joey12725/bubblelink/hardware/pcb/BubbleLink_CTRL_v1_2_PCBWay/verification/manufacturing_qa/REQUIREMENTS_TRACEABILITY.md

# Manufacturing QA requirements traceability

| ID | Frozen requirement | Source / rationale | Automated evidence | Release criterion | Manual complement |
|---|---|---|---|---|---|
| MQA-001 | Exact component population, values, MPNs, mount technology, and DNP state | `frozen_design.json`; design source; DFM BOM | `CMP-001`–`CMP-004` | Exact match | Confirm received reels/labels and no unapproved substitution |
| MQA-002 | Standard and polarity-critical pin mapping is preserved from logical pin through physical pad | Device datasheet pinouts frozen in `critical_pin_labels` | `PIN-001`, `PIN-002`, `KIC-005` | No missing, extra, or renumbered pad | Inspect PCBWay placement preview/photo for pin 1 and D1 cathode |
| MQA-003 | Controller and pump topology is exact | Frozen 23 connectivity groups, explicit N−1 trees, and PRIME internal pole pairs | `NET-001`, `NET-002`, `NET-003`, `KIC-006` | Every expected endpoint shares only its frozen net; 111 two-terminal edges form cycle-free trees; switch pairs are 1-2 and 3-4 | Probe assembled-board shorts/continuity before power |
| MQA-004 | Board is 50 × 40 mm, two-layer, 1.6 mm FR-4 | System docs and PCBWay order handoff | `BRD-001`, `GBR-003`, `KIC-002` | Three serialized representations agree | Confirm quote selection remains 1.6 mm / 2 layer / 1 oz |
| MQA-005 | Four 3.2 mm NPTH holes use the 43 × 33 mm pattern | Mechanical requirements | `BRD-002`, `GBR-005`, `KIC-007` | Exact count, diameter, and relative coordinates | 1:1 print and hardware dry-fit |
| MQA-006 | Mounting holes have 1.0 mm copper-edge clearance on both layers | Electrical/mechanical robustness requirement | `BRD-003`, `BRD-004` | Both-layer keepouts and geometric copper clearance pass | Inspect CAM render on both copper layers |
| MQA-007 | No unresolved serialized PCB or DRC/unconnected error | Fabrication release baseline | `CIR-003`, `CIR-004`, `DRC-001` | All counts zero | PCBWay CAM feedback resolved before approval |
| MQA-008 | General copper width ≥0.20 mm; pump paths are actually ≥1.0/1.2 mm and do not neck through single series vias; J1+→TP1 is a classified 0.75 mm non-load measurement spur | Current capacity, mounting keepout, and fabrication floor | `TRC-001`–`TRC-005`, `GBR-004`, `KIC-003` | Every representation meets its applicable floor; load-current edges are via-free except the exact reviewed three-via GND bank; the 0.75 mm exception terminates only at TP1 | Review high-current path geometry and thermal behavior |
| MQA-016 | J1 GND→Q2 source uses exactly three 0.30/0.60 mm vias at 0.85 mm pitch, at least 0.25 mm pad-edge spacing, and one continuous bottom GND pour | Release-critical current-return review | `TRC-005` | Exact via/transition coordinates and GND connectivity key match; all three via pads overlap top copper; all bank centers and ten bottom-route points lie in one bottom GND BREP | Inspect the bank and bottom pour in KiCad/CAM; confirm no thermal relief necking |
| MQA-017 | All 40 serialized component courtyards are present once and pairwise disjoint; reviewed R18/C12 gap is at least 0.06 mm | Independent aggregate placement audit after a 0.13 mm R18/C12 overlap was found | `CIR-002`, `PLC-001`, DRC aggregate-placement category | No courtyard overlap/touch; exact ownership/count; reviewed local clearance preserved | Inspect dense upper-left placement and access in KiCad/assembly render |
| MQA-009 | Exactly 56 vias use drill ≥0.30 mm and diameter ≥0.60 mm, with cross-export-consistent count; the PTH drill file has 42 component holes + 56 vias = 98 hits | PCBWay-capable robust geometry | `CIR-002`, `VIA-001`, `GBR-006`, `KIC-003`, `KIC-008` | No undersize via; exact counts agree across circuit, KiCad, and Excellon | Inspect tenting/plating selection in quote/CAM |
| MQA-010 | Exact nine-file, top-assembly two-layer Gerber/Excellon set is parseable; bottom paste/legend are absent | PCBWay fabrication upload requirement | `GBR-001`, `GBR-002`, `GBR-003`, `GBR-005`, `GBR-006` | Exact required roles/count, syntax, dimensions, and drills pass; forbidden bottom assembly roles absent | PCBWay CAM preview sign-off |
| MQA-018 | F.Paste is flash-only and contains exactly the 92 populated top-SMT rectangles at full 1.00× copper-pad dimensions; no R22 DNP, PTH, fiducial, or bottom aperture | Prevent under-printed joints, DNP loading, paste on through-hole pads/fiducials, and accidental bottom assembly | `GBR-007` | One-to-one center and rectangle-dimension match to copper pads owned by the 41 populated SMT refs | Inspect isolated F.Paste CAM preview before assembly approval |
| MQA-011 | KiCad source is a routed, matching, inspectable manufacturing representation | Editable-source and cross-export requirement | `KIC-001`–`KIC-007` | Stack, traces, footprints, pads, nets, and holes pass | Open in KiCad and inspect zones, courtyard, mask, legend |
| MQA-012 | PCBWay BOM contains exactly the 41 top-SMT refs with reconciled quantities and exact MPNs | Assembly scope | `BOM-001`, `BOM-002` | No missing/extra/DNP/THT ref; all MPN/value checks pass | Approve substitutions only through engineering review |
| MQA-013 | CPL contains exactly one valid top placement for each BOM ref | Assembly scope | `CPL-001`, `CPL-002` | BOM=CPL=41 refs; positions/rotations reconcile | Verify PCBWay placement preview and polarity drawing |
| MQA-014 | Every ordered artifact is frozen by SHA-256 | Prevent mixed/stale exports | `HASH-001`, `HASH-002` | All bytes match and all inputs are covered | Record the passing report alongside the quote/order |
| MQA-015 | Automated manufacturing pass does not waive external hardware gates | Limits of CAD/model evidence | Explicit `PENDING`/README separation | Release command exits 0 **and** system-doc bench gates signed | ACS window, pump/PTC, startup, EMI, fit, moisture/vibration tests |
