joey12725/bubblelink/hardware/pcb/BubbleLink_CTRL_v1_2_PCBWay/verification/analog_model/requirements_traceability.csv

requirement_id | source | source_section | requirement | frozen_implementation | automated_test_ids | manual_test_ids | verification_status | release_gate
BL-PWR-001 | 02_PCB_Design_Input_Specification.md | 6.1 Power-up | Pump remains off at power-up. | TLV1822 open-drain POR is Hi-Z; TLV803 clamps HOLD through R23; Q3 is off and R15 holds Q2 gate low. | SAFE-001;PWR-000;PWR-001;PWR-002;MC | PWR-004 | MODEL_PASS_BENCH_REQUIRED | Zero pump motion during hard plug and 0.1/1/10/100 V/s ramps
BL-PWR-002 | 02_PCB_Design_Input_Specification.md | 5 Electrical interfaces | J1 accepts 4.75-5.25 V. | References are ratiometric; U2 A43 is below the minimum normal rail. | DET-001;DET-002;TMR-001;PWR-001;MC | B-001;PWR-004 | MODEL_PASS_BENCH_REQUIRED | All rails and functions pass at 4.75/5.00/5.25 V
BL-IDLE-001 | 02_PCB_Design_Input_Specification.md | 6.2 Idle | DET_N high; HOLD low; pump off. | Detector pull-up plus R21 HOLD decay; U1B released; Q3 off; R15 gate pulldown. | SAFE-001;TMR-004;PWR-000 | B-002 | MODEL_PASS_BENCH_REQUIRED | Q2 gate remains below 0.02 V at idle over temperature
BL-DET-001 | 02_PCB_Design_Input_Specification.md | 6.3 Gun starts | ACS_OUT rise asserts detection and starts pump. | R1/C5 filter; U1A; Q1 DMP2065UQ-7 charges HOLD through R20; U1B/Q3 command Q2. | DET-001;DET-003;DET-005;START-001;START-002;MC | B-003;B-006 | MODEL_PASS_BENCH_REQUIRED | Minimum qualified real gun profile detects at 0/25/50 C
BL-DET-002 | 02_PCB_Design_Input_Specification.md | 2 Functions included | Reject motor noise and current chatter. | R1/C5 low-pass plus R5 detector hysteresis; R19 limits wiper loading. | DET-001;DET-004;DET-005;MC | B-003;EMI-001 | MODEL_PASS_BENCH_REQUIRED | No false or multiple DET_N transitions during PWM and EMI tests
BL-DET-003 | 02_PCB_Design_Input_Specification.md | 7 Adjustable ranges | VTH adjustable approximately 2.20-2.80 V. | R2/RV1/R3 divider with R19 and R5 included in exact nodal model. | DET-002;MC | B-003 | MODEL_PASS_BENCH_REQUIRED | Measured RV1 endpoints include actual idle/active sensor window
BL-DET-004 | 03_Controller_Circuit_Requirements.md | 3 Comparator A output and hysteresis | R5=4.7 MOhm and hysteresis only a few millivolts. | R5 is 4.7 MOhm from DET_N to VTH. | DET-001;MC | B-003 | MODEL_PASS_BENCH_REQUIRED | Measured turn-on/release separation 3-7 mV without chatter
BL-STOP-001 | 02_PCB_Design_Input_Specification.md | 6.4 Gun stops | Pump continues for adjustable delay then turns off. | HOLD discharges through (R9+RV2)||R21 to the U1B falling threshold. | TMR-002;TMR-003;TMR-004;MC | B-004 | MODEL_PASS_BENCH_REQUIRED | Every trigger release shuts pump off; 350 ms target reachable
BL-TMR-001 | Frozen circuit.tsx | Timer comparator | U1B +=VDELAY and -=HOLD with active-low TIMER_N. | TLV1822 channel B sinks TIMER_N only while HOLD exceeds VDELAY; Q3 then sources Q2 gate. | SAFE-001;START-001;TMR-001 | PWR-004 | MODEL_PASS_BENCH_REQUIRED | Correct active-low TIMER_N truth table on hardware
BL-TMR-002 | Frozen circuit.tsx | True hysteresis | R13=4.7 MOhm TIMER_N-to-VDELAY. | R13 shifts VDELAY high while off and low while on. | TMR-001;MC | EMI-001 | MODEL_PASS_BENCH_REQUIRED | One clean timer transition during 10000 inductive cycles
BL-TMR-003 | Frozen circuit.tsx | Timer values | R9=10 kOhm; RV2=100 kOhm; R21=1 MOhm; C7=CGA5L1X7R1E685K160AC 6.8 uF. | R21 is permanent fail-safe discharge; exact C7 production part has 6.8 uF +/-10% X7R rating. | TMR-002;TMR-003;TMR-004;MC | B-004 | MODEL_PASS_BENCH_REQUIRED | Measure assembled C7 and all delay endpoints over 0-50 C
BL-TMR-004 | 02_PCB_Design_Input_Specification.md | 7 Adjustable ranges | Clockwise RV2 increases delay. | RV2 wiper is strapped to the high end; resistance from HOLD to ground increases 0-100 kOhm. | TMR-003 | B-004 | MODEL_PASS_BENCH_REQUIRED | Physical trimmer rotation verified clockwise-longer
BL-CHG-001 | Frozen circuit.tsx | HOLD fast charge | C6=22 uF C3225X7R1E226M250AB; R20=2.2 kOhm limits charge current. | Exact two-node C6/VMID-to-C7/HOLD transient model includes R20 and Q1. | START-001;START-002;MC | B-005 | MODEL_PASS_BENCH_REQUIRED | Assembled C6/C7 effective values and trigger latency measured at corners
BL-PRIME-001 | 02_PCB_Design_Input_Specification.md | 6.5 PRIME | Momentary PRIME grounds DET_N and uses normal delay path. | SW1/J4 drive DET_N; Q1/R20/U1B/Q3 use the normal command path. | START-001;TMR-002 | B-006 | MODEL_PASS_BENCH_REQUIRED | 1000 press/release cycles; release invokes configured delay
BL-Q1-001 | Frozen circuit.tsx | Q1 | Q1 is DMP2065UQ-7 and must charge HOLD at low DET_N drive. | DMP2065UQ threshold maximum 0.9 V; modeled current remains below its 250 uA threshold-test point. | START-001;START-002;MC | B-005 | MODEL_PASS_BENCH_REQUIRED | Q1 starts timer at 4.75 V and 0/50 C
BL-Q3-001 | Frozen circuit.tsx | Q3 | Q3 is DMP2065UQ-7 and pump gate must fail off. | Q3 leakage is discharged by R15=10 kOhm; C10=100 nF bounds gate decay. | SAFE-001;PWR-003;MC | B-002;PWR-004 | MODEL_PASS_BENCH_REQUIRED | Q2 gate <0.02 V static and no startup/brownout pulse
BL-SUP-001 | Frozen circuit.tsx | U2 pinout | U2 is TLV803EA43DBZR using standard DBZ pinout 1=GND 2=RESET_N 3=VDD. | Explicit physical pad labels and nets connect RESET_N to R23/HOLD. | none | B-009 | BENCH_REQUIRED | Independent pad-number/netlist and assembly-orientation audit
BL-SUP-002 | Frozen circuit.tsx | U2 startup | U2 A43 threshold and A delay must cover TLV1822 POR and slow ramps. | 4.38 V nominal falling threshold; 0.9-1.5% hysteresis; 130-270 ms release; controlled reset down to 0.7 V. | PWR-000;PWR-001;MC | PWR-004 | MODEL_PASS_BENCH_REQUIRED | Zero motion in 100 cycles per ramp/brownout case
BL-SUP-003 | Frozen circuit.tsx | U2 clamp | R23=560 Ohm clamps HOLD with headroom below U2 recommended current. | Model checks 3.0-5.25 V steady clamp and charged-C7 brownout transient separately. | PWR-002;PWR-003;MC | PWR-004 | MODEL_PASS_BENCH_REQUIRED | Scope RESET_N/HOLD; sink current proxy and off latency stay within limits
BL-DISC-001 | 02_PCB_Design_Input_Specification.md | 12 Design margins | Open pump connector tolerated indefinitely; sensor disconnect commands off. | R18 discharges ACS path; R21 discharges HOLD; Q3/R15 gate defaults off. | DISC-001;TMR-004;SAFE-001 | B-007 | MODEL_PASS_BENCH_REQUIRED | Full/VOUT disconnect off within 1 s; individual J2 faults characterized
BL-PUMP-001 | 03_Controller_Circuit_Requirements.md | 6 Pump driver | AO3400A low-side driver and flyback operate safely. | Q2 gate driven through Q3/R14; B340A diode and C9 are across pump output. | SAFE-001;PWR-003 | B-005;EMI-001 | BENCH_REQUIRED | Thermal/load and 10000-cycle inductive tests pass
BL-PUMP-002 | 02_PCB_Design_Input_Specification.md | 12 Design margins | Copper and driver support 1.5 A continuous and 3 A transient. | 1.2 mm pump traces and AO3400A remain sized for 1.5 A; F1 independently limits usable continuous current at temperature. | none | B-005 | BENCH_REQUIRED | Copper/driver drop and temperature rise pass; do not infer PTC capability
BL-PTC-001 | Frozen circuit.tsx | F1 | F1 is 1812L150/16DR and production pump must not nuisance-trip at 50 C. | Official hold-current derating is 1.10 A at 50 C despite 1.50 A at 20 C. | PTC-001 | B-010 | BENCH_REQUIRED | Measured worst continuous pump current <1.10 A at 50 C including blocked-filter case
BL-EMI-001 | 06_Verification_and_Test_Plan.md | 7 Actual G528 test | Pump switching must not disturb logic or chatter detector. | Board flyback/capacitor; separated returns; C10 gate shaping; supervisor brownout clamp. | DET-001;TMR-001;PWR-003 | EMI-001 | BENCH_REQUIRED | Drain <12 V; logic ripple <50 mVpp; zero false transitions in 10000 cycles
BL-ENV-001 | 02_PCB_Design_Input_Specification.md | 11 Environment | Operate at 0-50 C in a moving festival bag. | Automotive comparator/timer capacitor; PTC explicitly derated; calibration and enclosure controls. | MC | ENV-001;B-008;B-010 | BENCH_REQUIRED | Cold/hot functional; vibration; humidity; PTC current tests pass
BL-ACS-001 | 06_Verification_and_Test_Plan.md | 8 Actual ACS758 calibration | Measure zero output direction and sensitivity with real module. | Model accepts measured module inputs; nominal sensitivity 40 mV/A. | DET-003;DET-004;DET-005 | B-003 | BENCH_REQUIRED | Fixed threshold has >=15 mV plus 3 sigma noise margin each side
BL-MFG-001 | 06_Verification_and_Test_Plan.md | 1 Pre-fabrication review | ERC/DRC/BOM/CPL/polarity and footprints must be reviewed. | Verification suite supplements but does not replace CAD/manufacturing review. | none | B-009 | BENCH_REQUIRED | CAD audit clean; exact U1/U2/Q1/Q3/C6/C7/F1 parts and pinouts verified
