joey12725/bubblelink/hardware/pcb/BubbleLink_CTRL_v1_2_PCBWay/drawings/Gerber_bottom.png

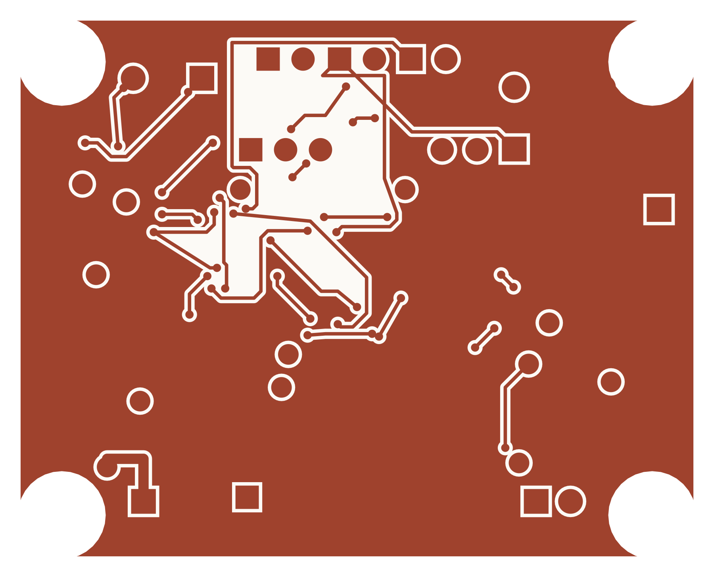
hardware/pcb/BubbleLink_CTRL_v1_2_PCBWay/drawings/Gerber_bottom.png
