joey12725/bubblelink/hardware/printed/renders/14_gun_dock_overview.png

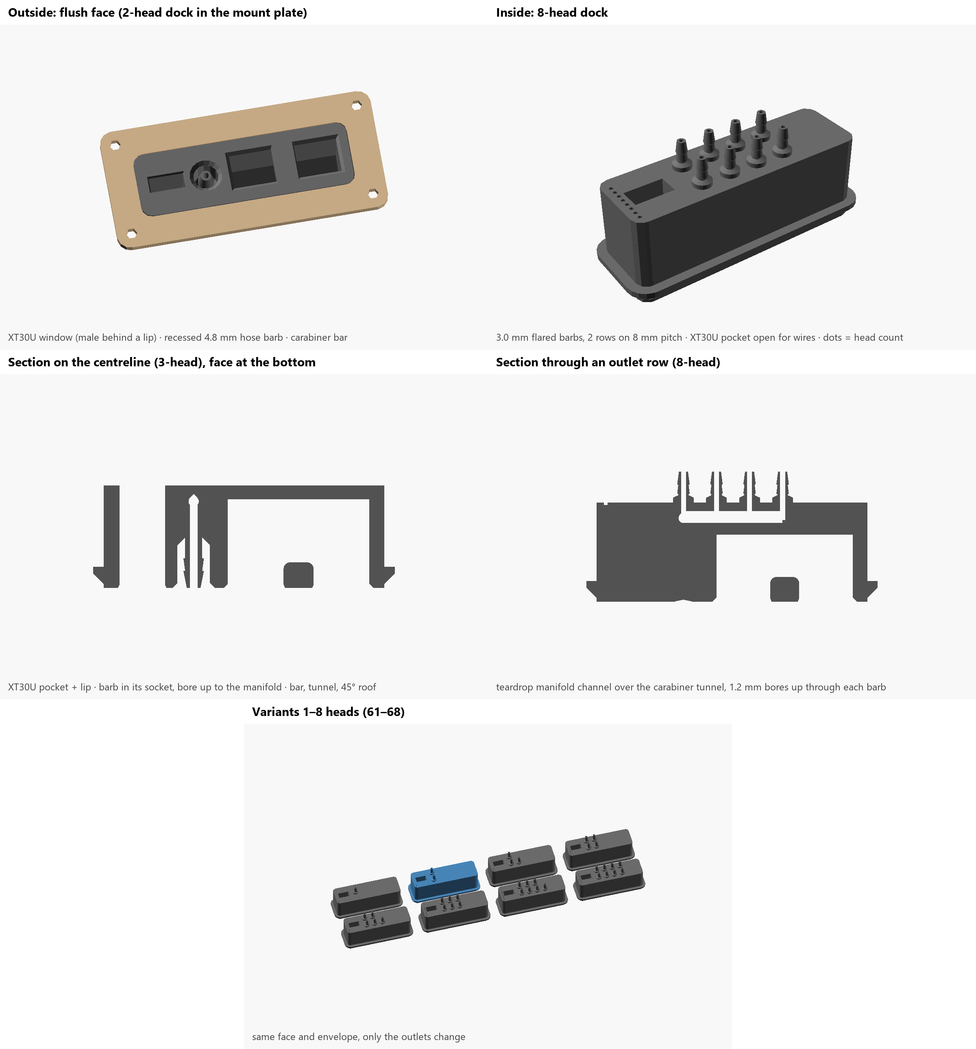
hardware/printed/renders/14_gun_dock_overview.png
