joey12725/bubblelink/hardware/printed/renders/15_duo_gun_overview.png

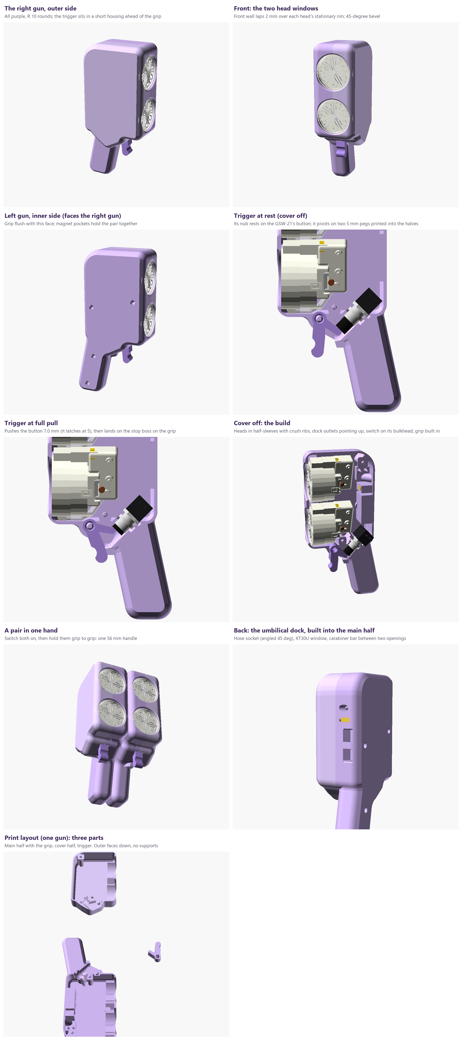
hardware/printed/renders/15_duo_gun_overview.png
