joey12725/bubblelink/hardware/pcb/BubbleLink_CTRL_v1_2_PCBWay/assembly/PCBWAY_SMT_BOM.csv

Item | Reference Designator | Quantity | Manufacturer | Manufacturer Part Number | Description | Package or Footprint | Layer | Substitution
1 | U1 | 1 | Texas Instruments | TLV1822QDRQ1 | Dual open-drain comparator | SOIC-8 | Top | NO SUBSTITUTE
2 | U2 | 1 | Texas Instruments | TLV803EA43DBZR | 4.38 V 200 ms supply supervisor; default DBZ pinout | SOT-23-3 DBZ | Top | NO SUBSTITUTE
3 | Q1,Q3 | 2 | Diodes Incorporated | DMP2065UQ-7 | P-channel MOSFET | SOT-23 | Top | NO SUBSTITUTE WITHOUT WRITTEN APPROVAL
4 | Q2 | 1 | Alpha & Omega Semiconductor | AO3400A | N-channel MOSFET | SOT-23 | Top | NO SUBSTITUTE WITHOUT WRITTEN APPROVAL
5 | D1 | 1 | Vishay | B340A-E3/61T | 3 A 40 V Schottky diode | SMA DO-214AC custom manufacturer land pattern | Top | NO SUBSTITUTE
6 | F1 | 1 | Littelfuse | 1812L150/16DR | 1.50 A hold 16 V resettable PTC | 1812 custom manufacturer land pattern | Top | NO SUBSTITUTE
7 | FB1 | 1 | Murata | BLM21PG221SN1D | 220 ohm at 100 MHz ferrite bead | 0805 | Top | NO SUBSTITUTE WITHOUT WRITTEN APPROVAL
8 | C2 | 1 | Murata | GRM31CR71C106KA12L | 10 uF 16 V X7R 10% | 1206 | Top | NO SUBSTITUTE WITHOUT WRITTEN APPROVAL
9 | C3,C4,C8,C9,C10,C11,C12 | 7 | Murata | GRM21BR71H104KA01L | 100 nF 50 V X7R 10% | 0805 | Top | EQUIVALENT ALLOWED
10 | C5 | 1 | Murata | GRM21BR71C105KA01L | 1 uF 16 V X7R 10% | 0805 | Top | EQUIVALENT ALLOWED
11 | C6 | 1 | TDK | C3225X7R1E226M250AB | 22 uF 25 V X7R 20% | 1210 | Top | NO SUBSTITUTE WITHOUT WRITTEN APPROVAL
12 | C7 | 1 | TDK | CGA5L1X7R1E685K160AC | 6.8 uF 25 V X7R 10% | 1206 | Top | NO SUBSTITUTE WITHOUT WRITTEN APPROVAL
13 | R14 | 1 | Yageo | RC0805FR-07100RL | 100 ohm 1% | 0805 | Top | EQUIVALENT ALLOWED
14 | R23 | 1 | Yageo | RC0805FR-07560RL | 560 ohm 1% | 0805 | Top | EQUIVALENT ALLOWED
15 | R6,R16,R17,R20 | 4 | Yageo | RC0805FR-072K2L | 2.2 kohm 1% | 0805 | Top | EQUIVALENT ALLOWED
16 | R7,R8 | 2 | Yageo | RC0805FR-074K7L | 4.7 kohm 1% | 0805 | Top | EQUIVALENT ALLOWED
17 | R2,R3 | 2 | Yageo | RC0805FR-077K5L | 7.5 kohm 1% | 0805 | Top | EQUIVALENT ALLOWED
18 | R1,R4,R9,R11,R12,R15 | 6 | Yageo | RC0805FR-0710KL | 10 kohm 1% | 0805 | Top | EQUIVALENT ALLOWED
19 | R10 | 1 | Yageo | RC0805FR-0739KL | 39 kohm 1% | 0805 | Top | EQUIVALENT ALLOWED
20 | R18 | 1 | Yageo | RC0805FR-07100KL | 100 kohm 1% required ACS pulldown | 0805 | Top | EQUIVALENT ALLOWED BUT MUST BE FITTED
21 | R19 | 1 | Yageo | RC0805FR-07220KL | 220 kohm 1% | 0805 | Top | EQUIVALENT ALLOWED
22 | R21 | 1 | Yageo | RC0805FR-071ML | 1 Mohm 1% | 0805 | Top | EQUIVALENT ALLOWED
23 | R5,R13 | 2 | Yageo | RC0805FR-074M7L | 4.7 Mohm 1% | 0805 | Top | EQUIVALENT ALLOWED
