joey12725/bubblelink/hardware/printed/stl/70_duo_main_L.stl

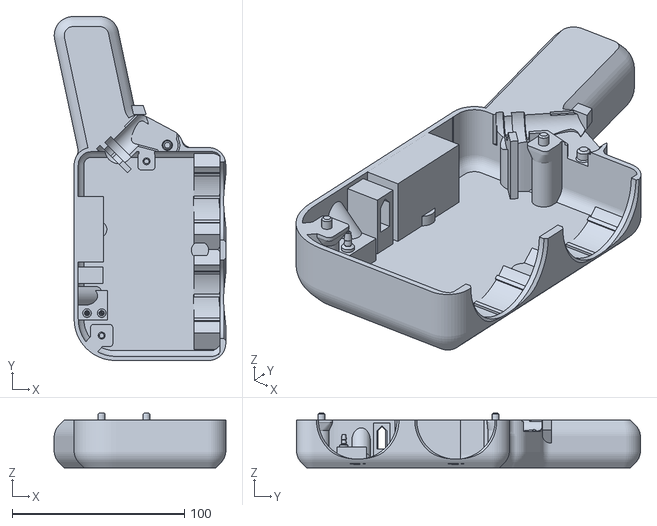
[picture p8: CAD file, 2026-10-29]
hardware/printed/stl/70_duo_main_L.stl
99.5 x 199.5 x 31.8
