joey12725/bubblelink/hardware/printed/stl/00_duo_test_main.stl

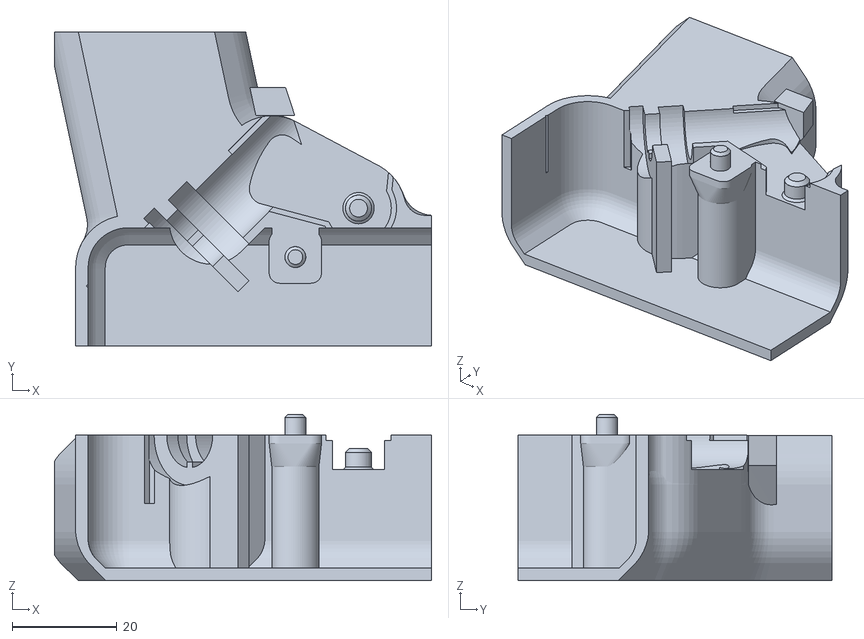
[picture p9: CAD file, 2026-10-29]
hardware/printed/stl/00_duo_test_main.stl
72.0 x 60.0 x 31.8
