joey12725/bubblelink/hardware/printed/stl/74_duo_trigger.stl

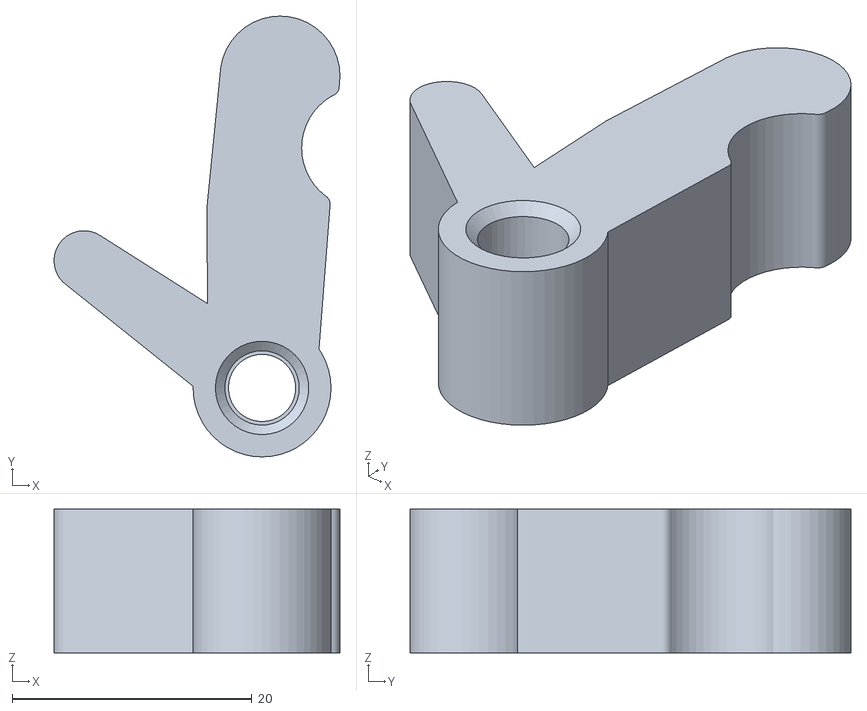
[picture p10: CAD file, 2026-10-29]
hardware/printed/stl/74_duo_trigger.stl
23.8 x 36.7 x 12.0
