joey12725/bubblelink/hardware/printed/stl/REF_blower_head.stl

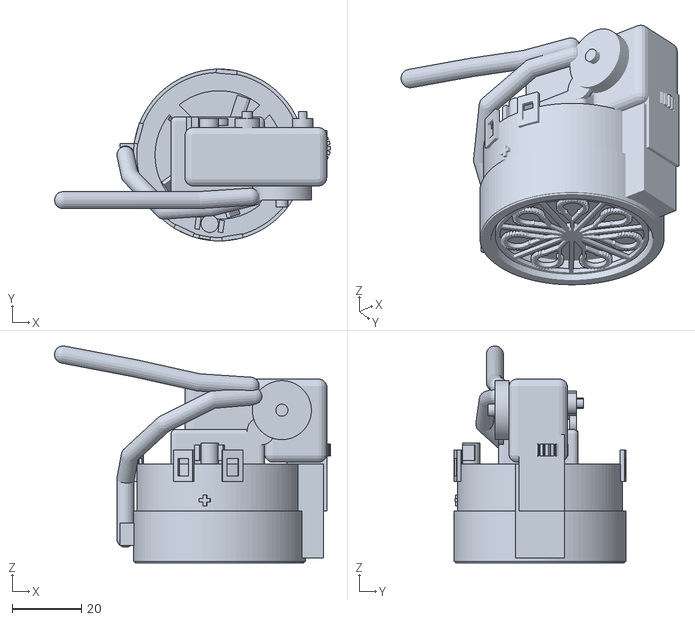
[picture p11: CAD file, 2026-10-29]
hardware/printed/stl/REF_blower_head.stl
79.5 x 49.6 x 62.5
