joey12725/bubblelink/hardware/printed/stl/73_duo_cover_R.stl

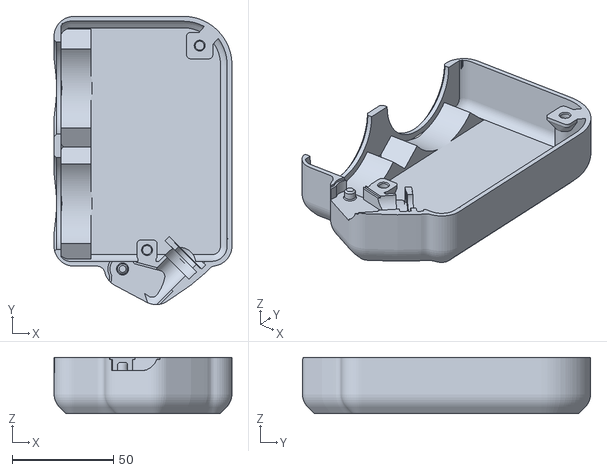
[picture p12: CAD file, 2026-10-29]
hardware/printed/stl/73_duo_cover_R.stl
88.0 x 142.5 x 27.8
