joey12725/bubblelink/hardware/printed/stl/00_duo_test_cover.stl

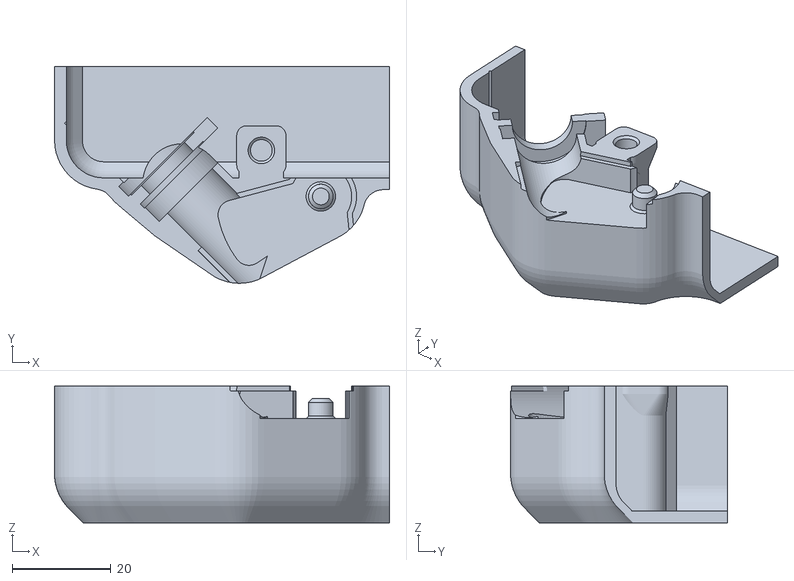
[picture p13: CAD file, 2026-10-29]
hardware/printed/stl/00_duo_test_cover.stl
68.0 x 44.0 x 27.8
