joey12725/bubblelink/hardware/printed/stl/51_head_collar_test.stl

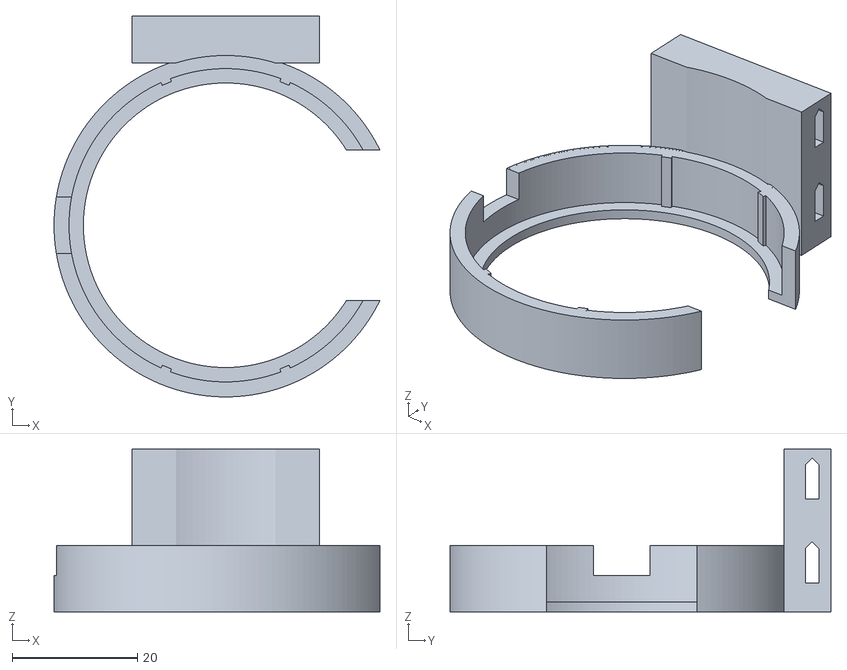
[picture p14: CAD file, 2026-10-28]
hardware/printed/stl/51_head_collar_test.stl
52.1 x 60.9 x 26.0
