joey12725/bubblelink/hardware/printed/stl/50_head_gauge_x5.stl

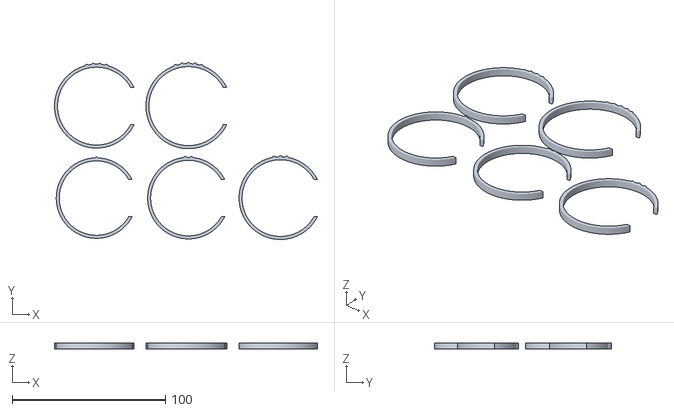
[picture p15: CAD file, 2026-10-28]
hardware/printed/stl/50_head_gauge_x5.stl
171.6 x 115.5 x 4.00
