joey12725/bubblelink/hardware/printed/stl/67_gun_dock_7head.stl

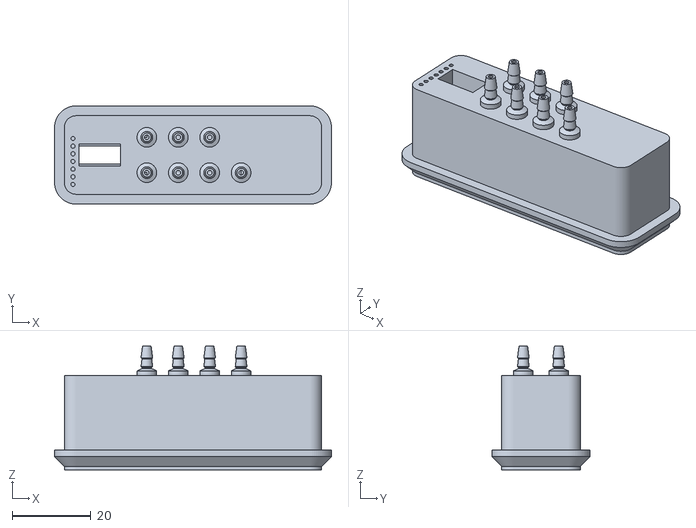
[picture p16: CAD file, 2026-10-28]
hardware/printed/stl/67_gun_dock_7head.stl
70.5 x 25.0 x 31.5
