joey12725/bubblelink/hardware/printed/stl/62_gun_dock_2head.stl

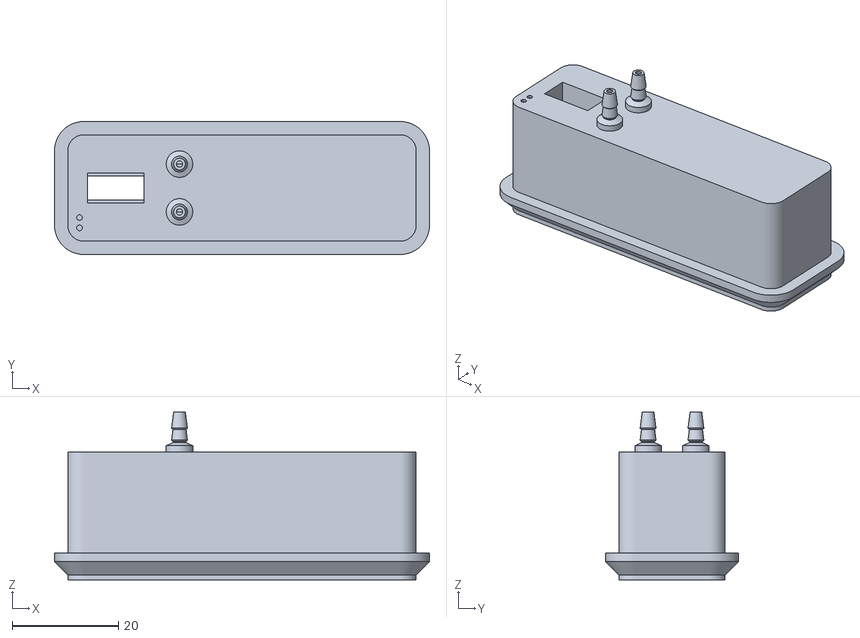
[picture p17: CAD file, 2026-10-28]
hardware/printed/stl/62_gun_dock_2head.stl
70.5 x 25.0 x 31.5
