joey12725/bubblelink/hardware/printed/stl/60_dock_barb_coupon.stl

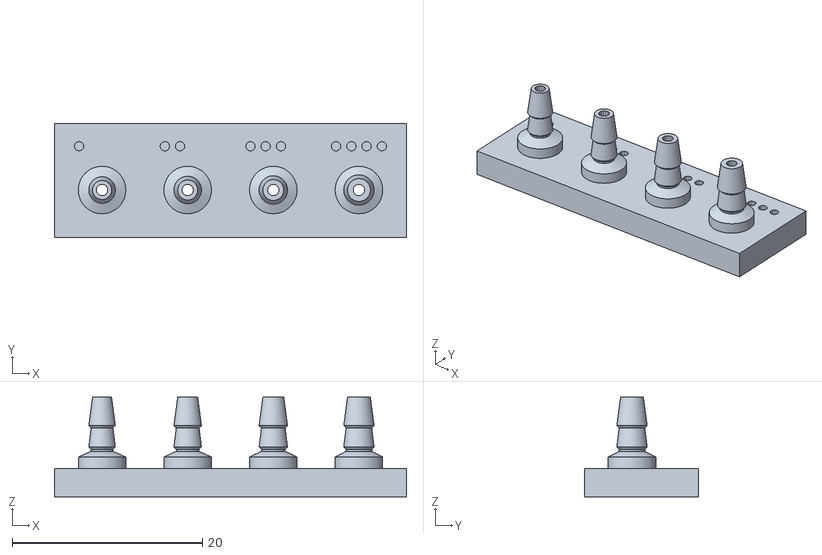
[picture p18: CAD file, 2026-10-28]
hardware/printed/stl/60_dock_barb_coupon.stl
37.0 x 12.0 x 10.5
