joey12725/bubblelink/hardware/printed/stl/69_dock_mount_plate.stl

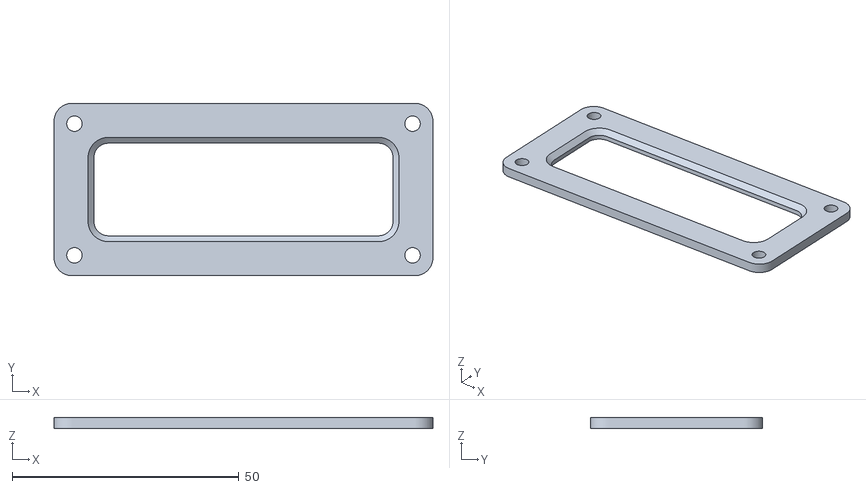
[picture p19: CAD file, 2026-10-28]
hardware/printed/stl/69_dock_mount_plate.stl
83.5 x 38.0 x 2.40
