joey12725/bubblelink/hardware/printed/stl/11_hose_adapter_8.0mm.3mf

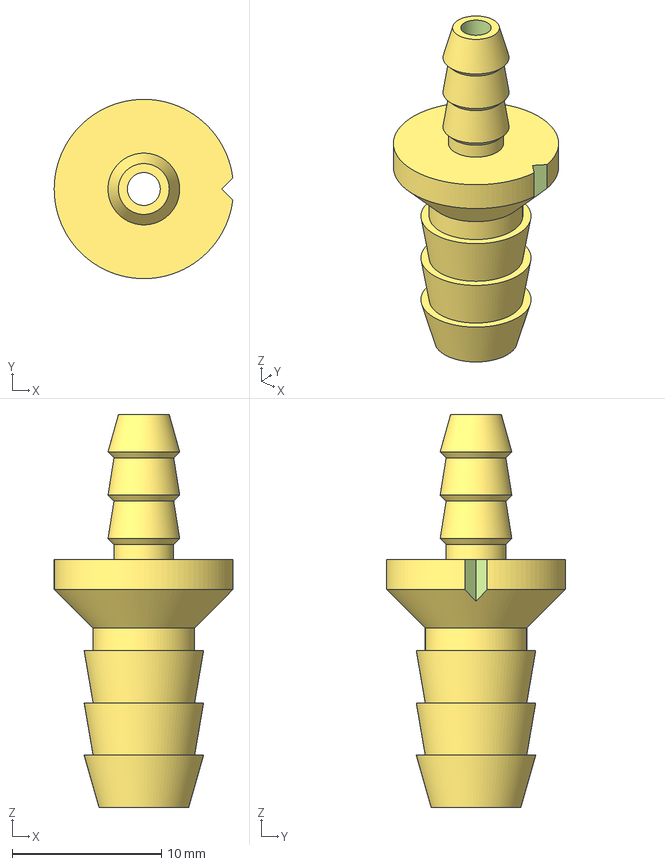
[picture p20: CAD file, 2026-10-28]
hardware/printed/stl/11_hose_adapter_8.0mm.3mf
12.0 x 12.0 x 26.3 mm
