joey12725/bubblelink/hardware/printed/stl/33_TPU_prime_boot.stl

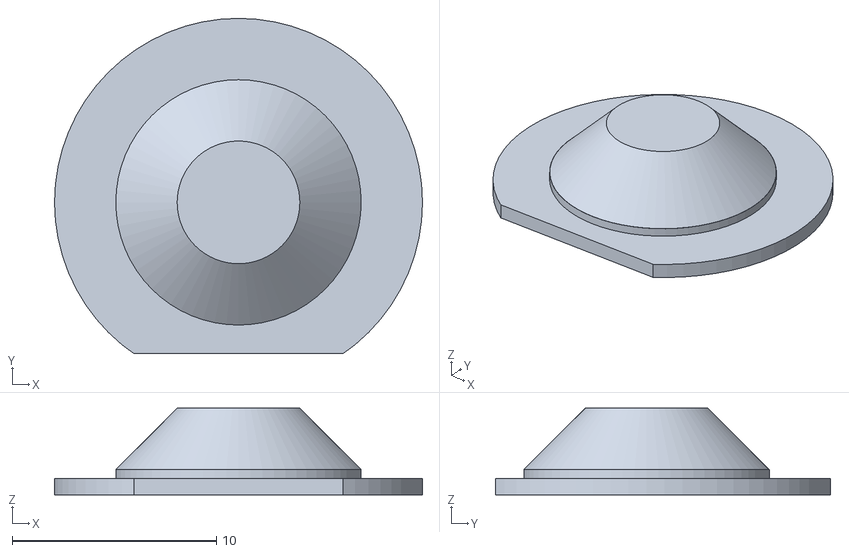
[picture p22: CAD file, 2026-10-26]
hardware/printed/stl/33_TPU_prime_boot.stl
18.0 x 16.4 x 4.24
