joey12725/bubblelink/hardware/printed/stl/24_stick_prime_bezel.stl

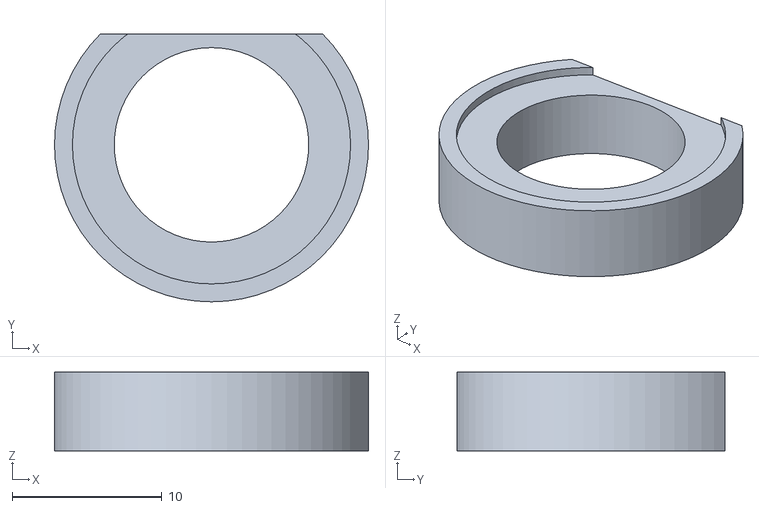
[picture p23: CAD file, 2026-10-26]
hardware/printed/stl/24_stick_prime_bezel.stl
21.0 x 17.9 x 5.25
