joey12725/bubblelink/hardware/printed/stl/00_stick_coupon_rim.stl

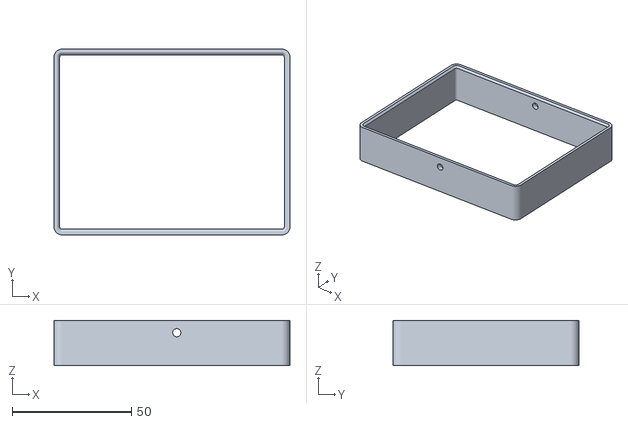
[picture p24: CAD file, 2026-10-26]
hardware/printed/stl/00_stick_coupon_rim.stl
98.8 x 77.8 x 19.0
