joey12725/bubblelink/hardware/printed/stl/01_cell_holder_MID.stl

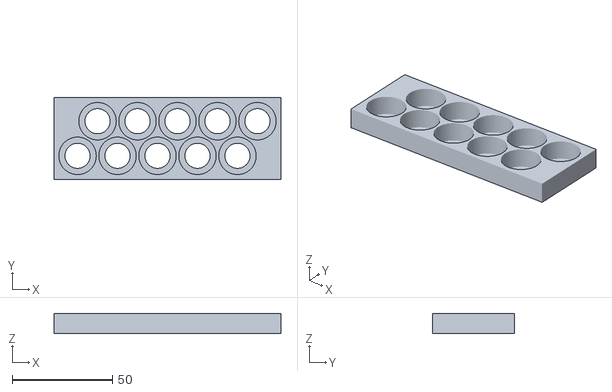
[picture p25: CAD file, 2026-10-26]
hardware/printed/stl/01_cell_holder_MID.stl
113.0 x 40.7 x 10.0
