joey12725/bubblelink/hardware/printed/stl/42_TPU_gun_port_cap_x2.stl

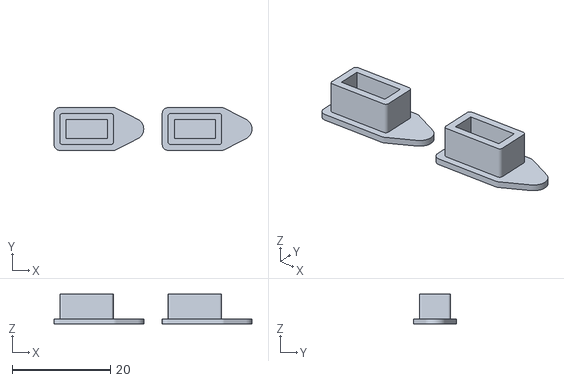
[picture p26: CAD file, 2026-10-26]
hardware/printed/stl/42_TPU_gun_port_cap_x2.stl
40.3 x 8.70 x 6.00
