joey12725/bubblelink/hardware/printed/stl/37_TPU_pump_mat.stl

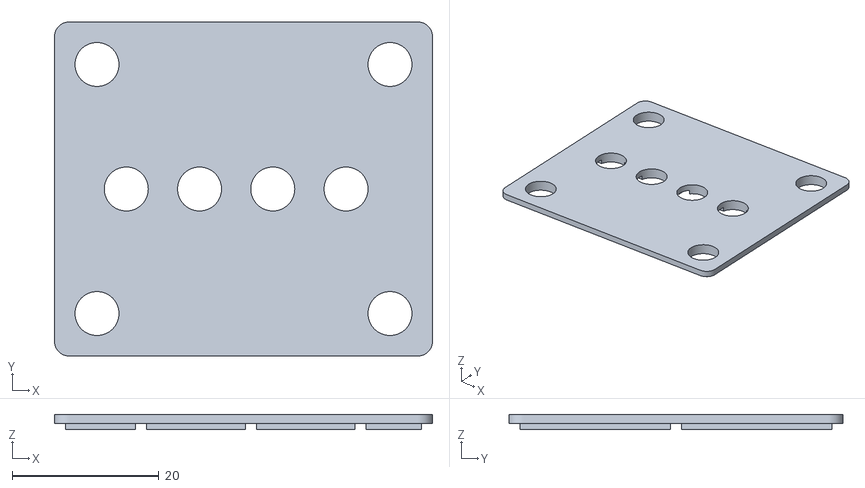
[picture p27: CAD file, 2026-10-26]
hardware/printed/stl/37_TPU_pump_mat.stl
51.6 x 45.6 x 2.00
