joey12725/bubblelink/hardware/printed/stl/36_TPU_battery_pad_x2.stl

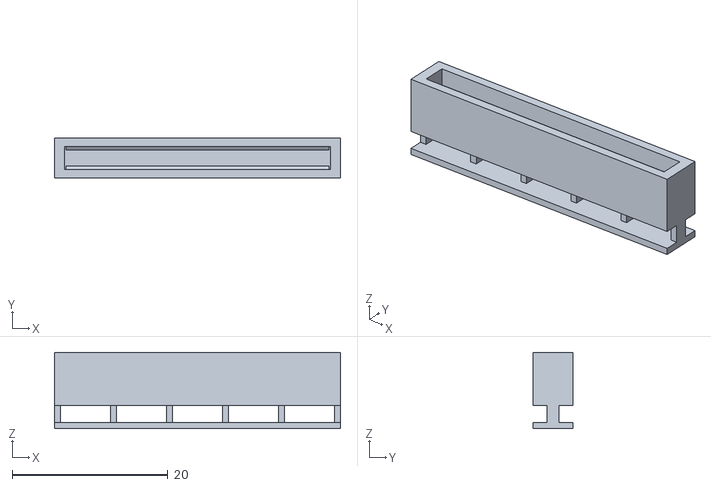
[picture p28: CAD file, 2026-10-26]
hardware/printed/stl/36_TPU_battery_pad_x2.stl
36.7 x 5.10 x 9.80
