joey12725/bubblelink/hardware/printed/stl/10_umbilical_brick_x2.stl

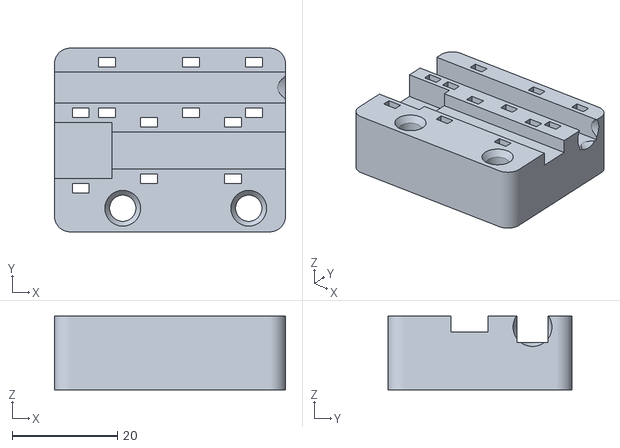
[picture p29: CAD file, 2026-10-26]
hardware/printed/stl/10_umbilical_brick_x2.stl
44.0 x 35.0 x 14.0
