joey12725/bubblelink/hardware/printed/stl/40_TPU_usbc_plug.stl

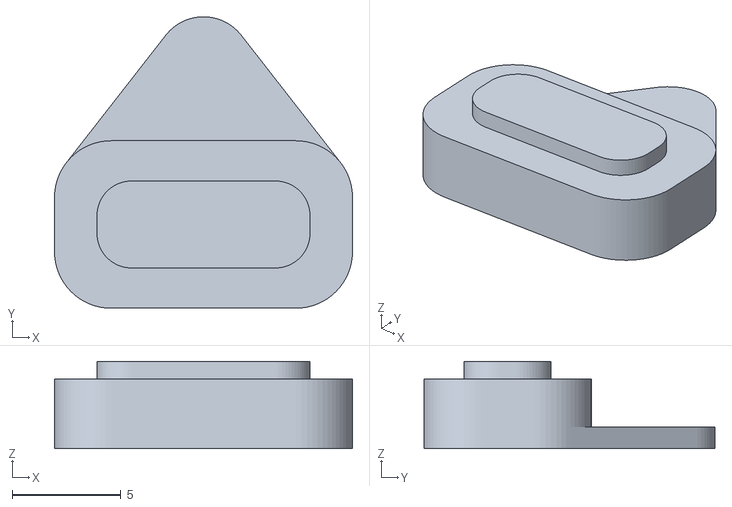
[picture p30: CAD file, 2026-10-26]
hardware/printed/stl/40_TPU_usbc_plug.stl
13.7 x 13.4 x 4.00
