joey12725/bubblelink/hardware/printed/stl/25_stick_grommet_skirt.stl

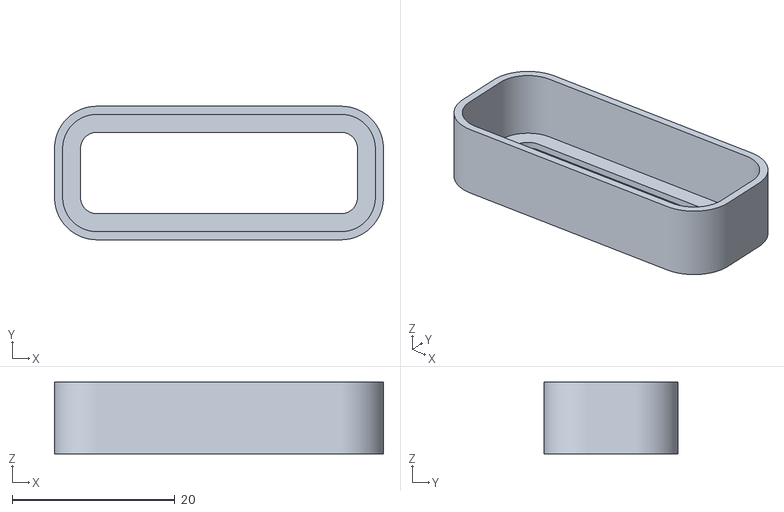
[picture p31: CAD file, 2026-10-26]
hardware/printed/stl/25_stick_grommet_skirt.stl
40.4 x 16.4 x 8.80
