joey12725/bubblelink/hardware/printed/stl/27_stick_pcb_spacer_x6.stl

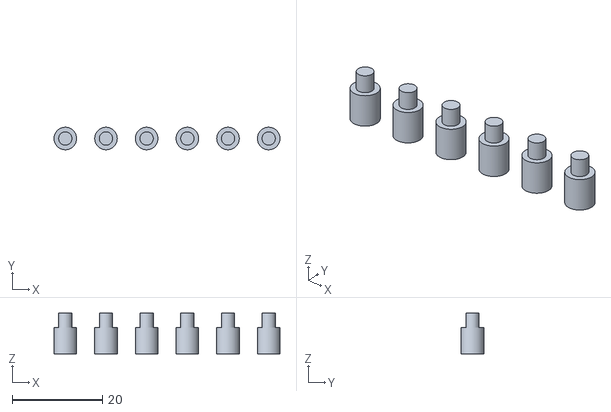
[picture p32: CAD file, 2026-10-26]
hardware/printed/stl/27_stick_pcb_spacer_x6.stl
50.0 x 5.00 x 9.00
