joey12725/bubblelink/hardware/printed/stl/00_stick_coupon_ports.stl

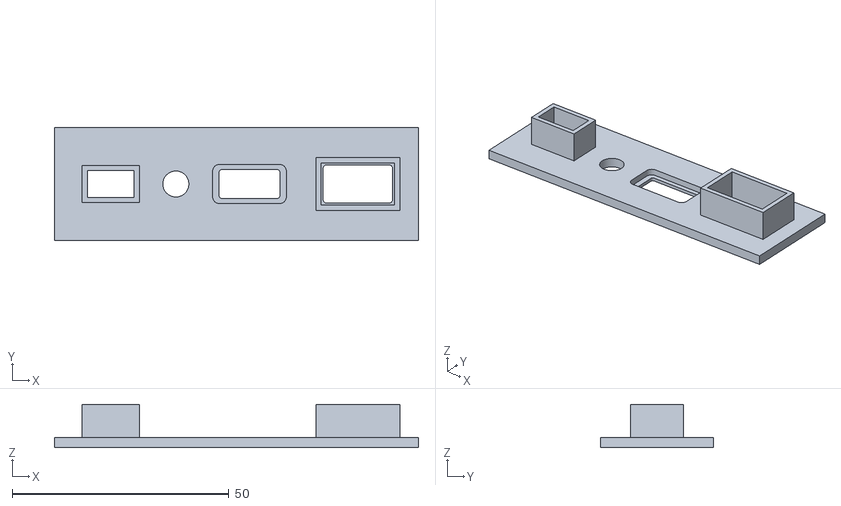
[picture p33: CAD file, 2026-10-26]
hardware/printed/stl/00_stick_coupon_ports.stl
84.0 x 26.0 x 10.0
