joey12725/bubblelink/hardware/printed/stl/32_TPU_grommet_upper.stl

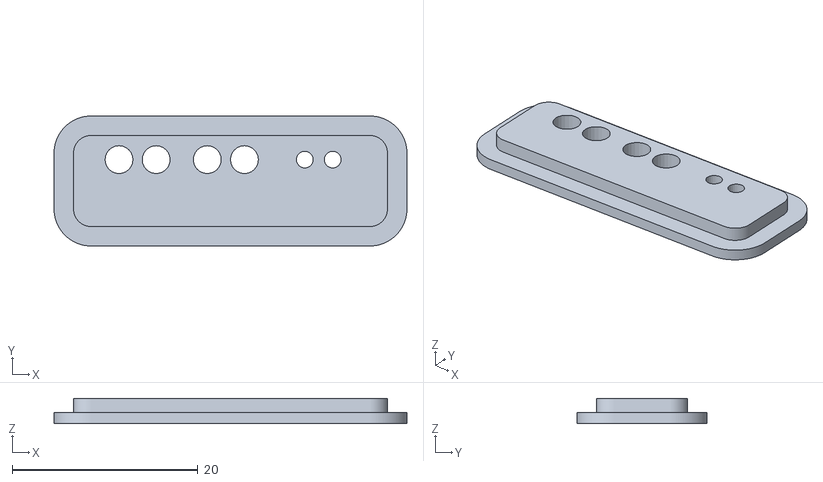
[picture p34: CAD file, 2026-10-26]
hardware/printed/stl/32_TPU_grommet_upper.stl
38.0 x 14.0 x 2.70
