joey12725/bubblelink/hardware/printed/stl/23_stick_cup.stl

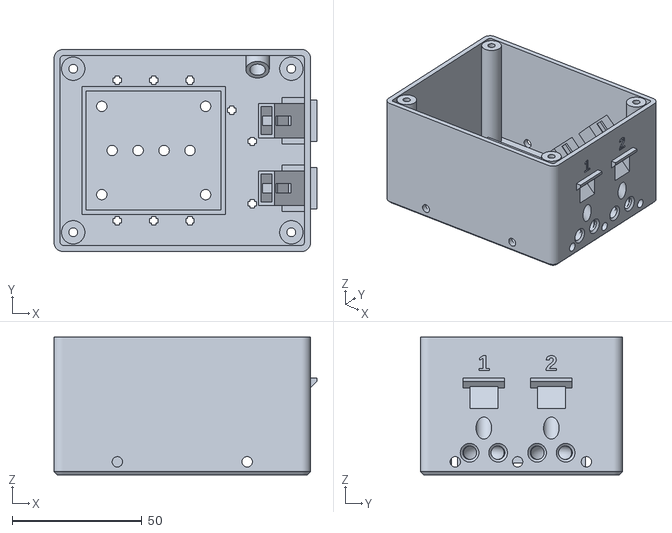
[picture p35: CAD file, 2026-10-26]
hardware/printed/stl/23_stick_cup.stl
101.3 x 77.8 x 53.0
