joey12725/bubblelink/hardware/printed/stl/41_TPU_usbA_plug.stl

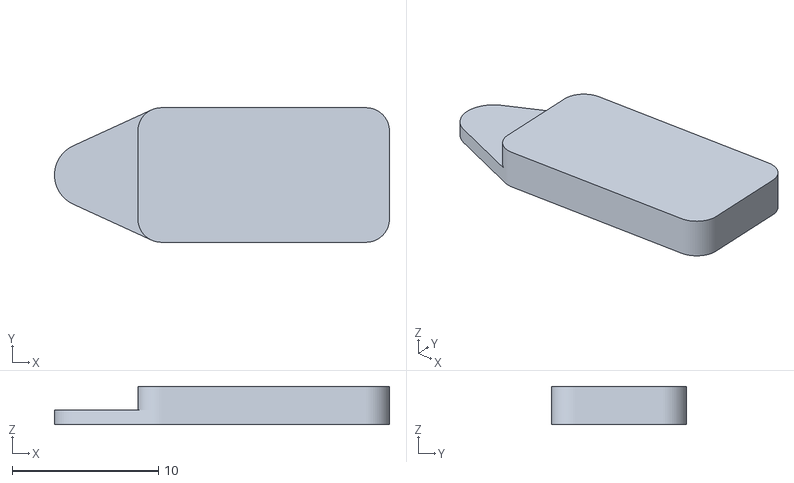
[picture p36: CAD file, 2026-10-26]
hardware/printed/stl/41_TPU_usbA_plug.stl
22.9 x 9.20 x 2.60
