joey12725/bubblelink/hardware/printed/stl/39_TPU_trimmer_plug.stl

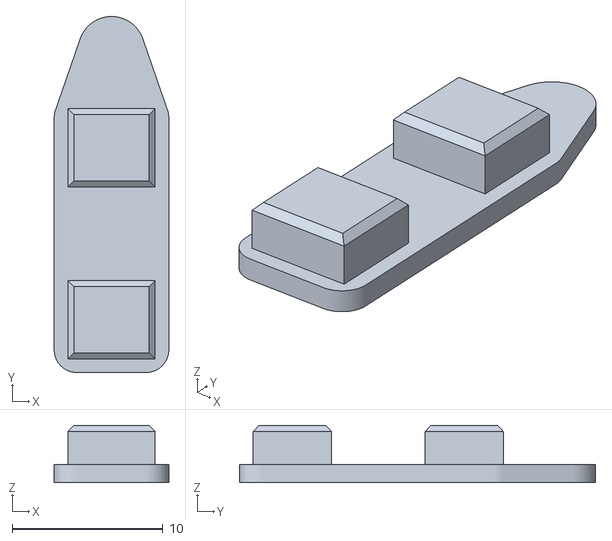
[picture p37: CAD file, 2026-10-26]
hardware/printed/stl/39_TPU_trimmer_plug.stl
7.60 x 23.6 x 3.80
