joey12725/bubblelink/hardware/printed/stl/22_stick_sled.stl

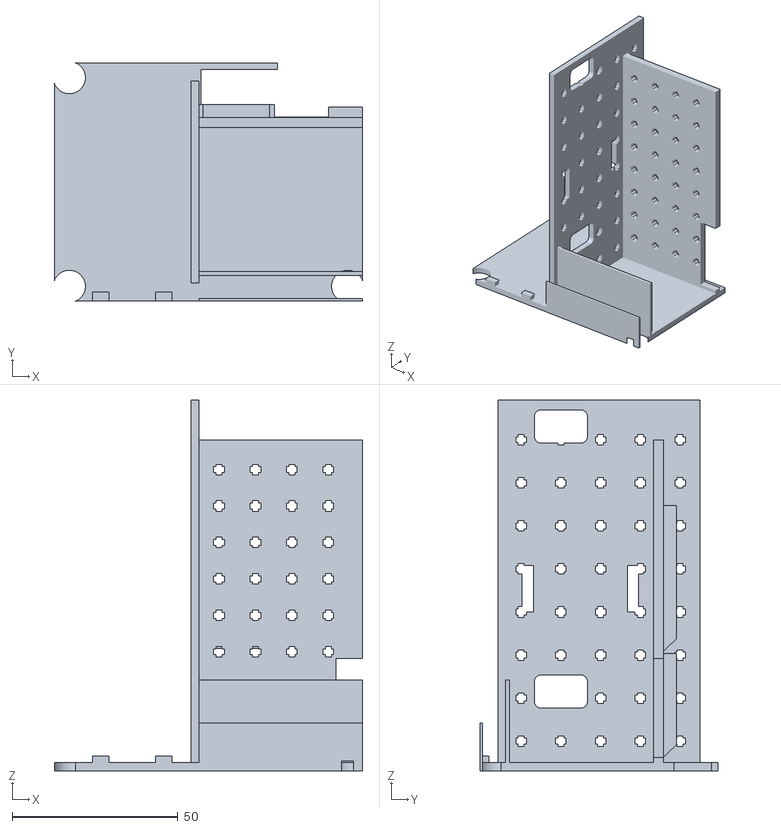
[picture p38: CAD file, 2026-10-26]
hardware/printed/stl/22_stick_sled.stl
93.0 x 72.0 x 112.0
