joey12725/bubblelink/hardware/printed/stl/21_stick_cap.stl

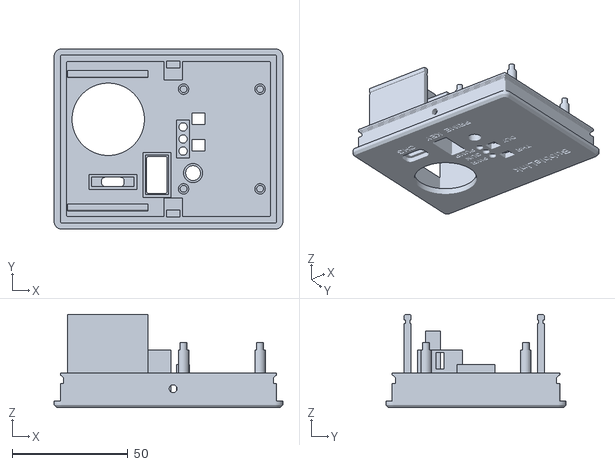
[picture p39: CAD file, 2026-10-26]
hardware/printed/stl/21_stick_cap.stl
98.8 x 77.8 x 40.3
