joey12725/bubblelink/hardware/printed/stl/20_stick_tube.stl

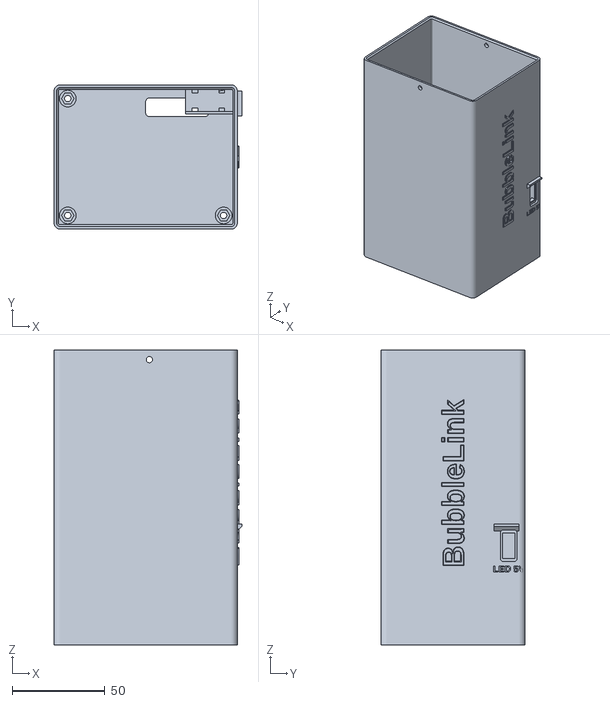
[picture p40: CAD file, 2026-10-26]
hardware/printed/stl/20_stick_tube.stl
101.3 x 77.8 x 159.0
