joey12725/bubblelink/hardware/printed/stl/30_TPU_cap_ring.stl

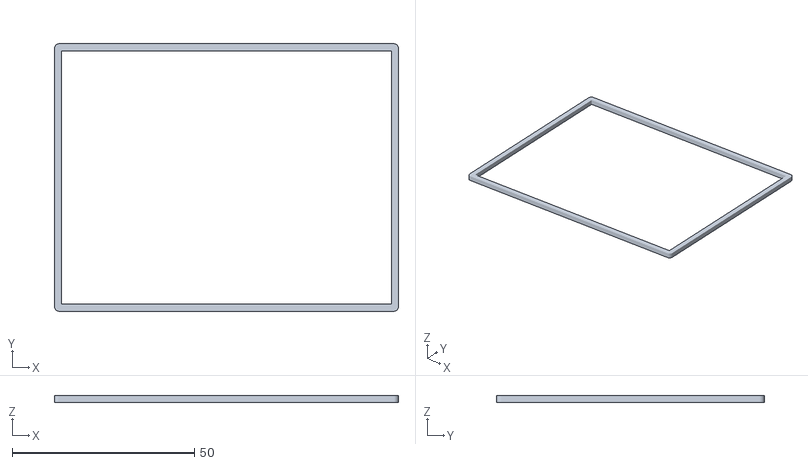
[picture p41: CAD file, 2026-10-26]
hardware/printed/stl/30_TPU_cap_ring.stl
94.5 x 73.5 x 1.80
