joey12725/bubblelink/hardware/printed/stl/09_slide_clamp_x3.stl

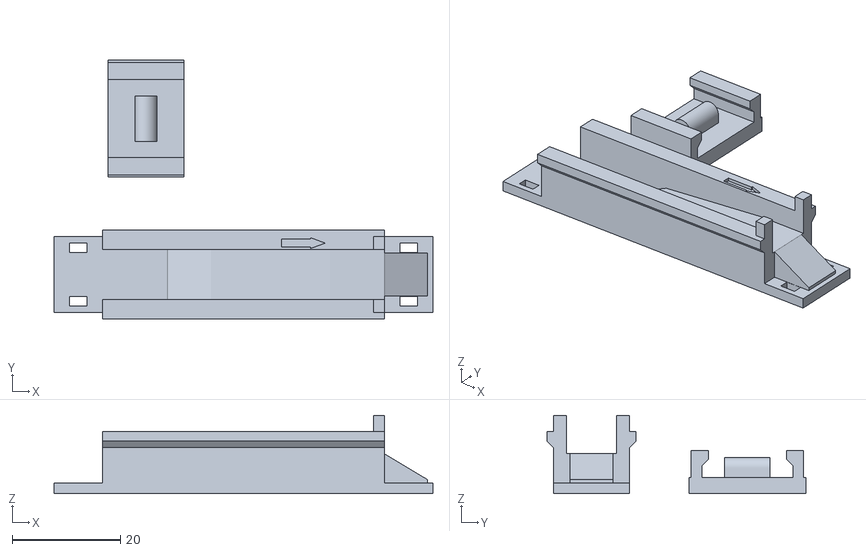
[picture p42: CAD file, 2026-10-26]
hardware/printed/stl/09_slide_clamp_x3.stl
70.0 x 47.8 x 14.5
