joey12725/bubblelink/hardware/printed/stl/44_TPU_key_gasket.stl

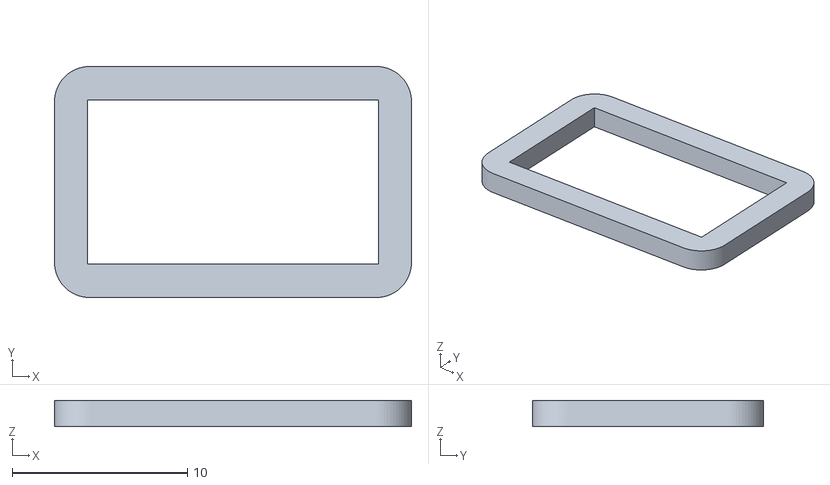
[picture p43: CAD file, 2026-10-26]
hardware/printed/stl/44_TPU_key_gasket.stl
20.4 x 13.2 x 1.50
