joey12725/bubblelink/hardware/printed/stl/43_TPU_key_blank.stl

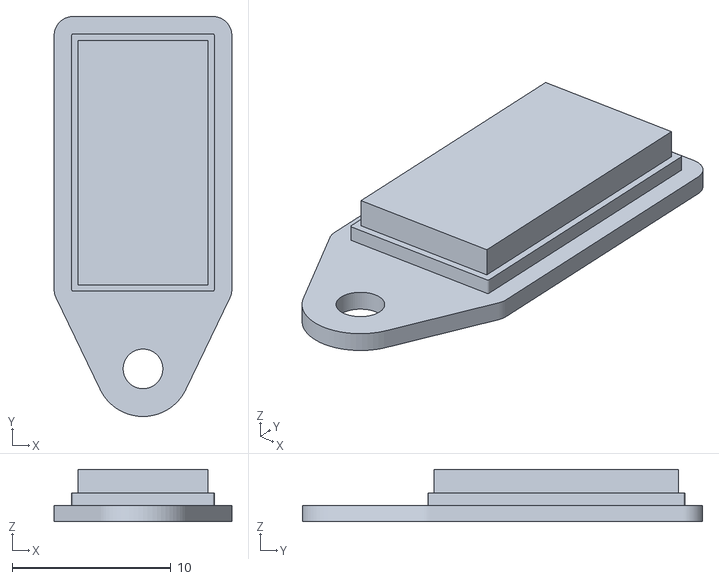
[picture p44: CAD file, 2026-10-26]
hardware/printed/stl/43_TPU_key_blank.stl
11.2 x 25.2 x 3.29
