joey12725/bubblelink/hardware/printed/stl/00_stick_coupon_cap.stl

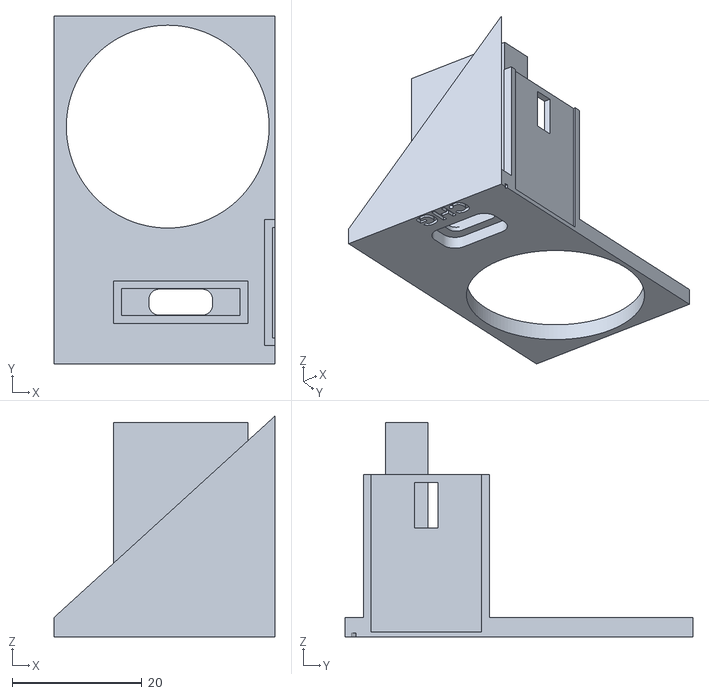
[picture p45: CAD file, 2026-10-26]
hardware/printed/stl/00_stick_coupon_cap.stl
34.0 x 53.5 x 34.0
