joey12725/bubblelink/hardware/printed/stl/31_TPU_grommet_lower.stl

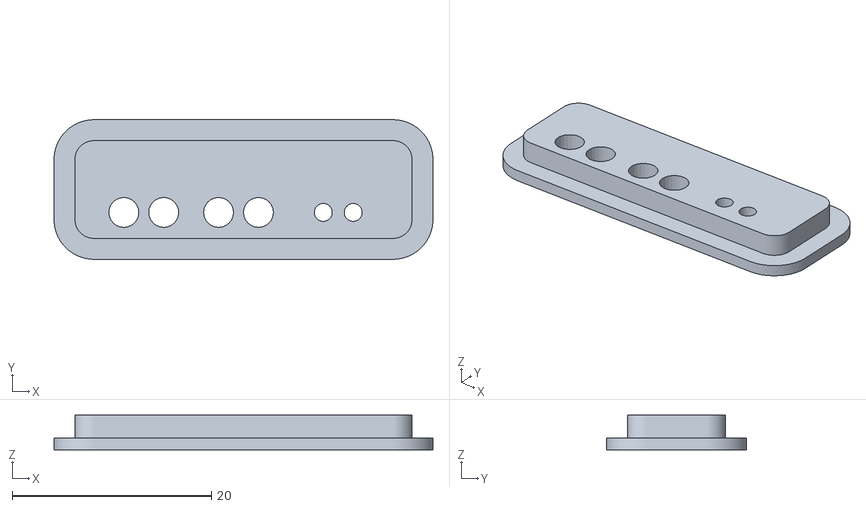
[picture p46: CAD file, 2026-10-26]
hardware/printed/stl/31_TPU_grommet_lower.stl
38.0 x 14.0 x 3.50
