joey12725/bubblelink/hardware/printed/stl/38_TPU_shim_strip_set.stl

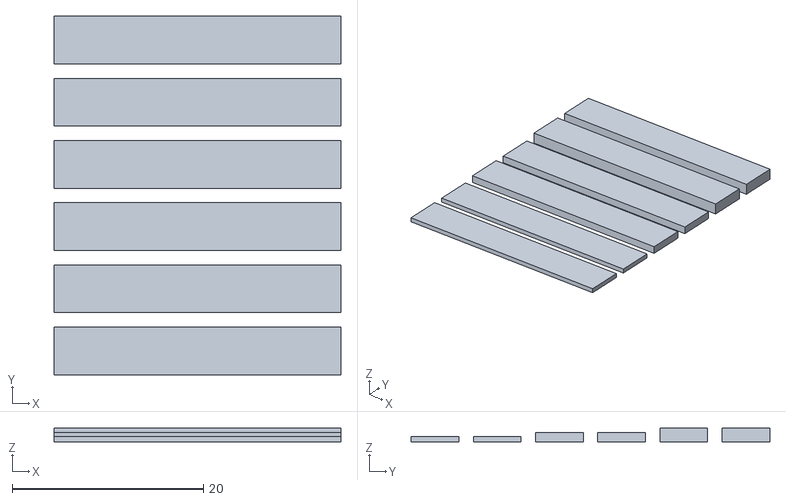
[picture p47: CAD file, 2026-10-26]
hardware/printed/stl/38_TPU_shim_strip_set.stl
30.0 x 37.5 x 1.50
