joey12725/bubblelink/hardware/printed/stl/00_fit_coupon.stl

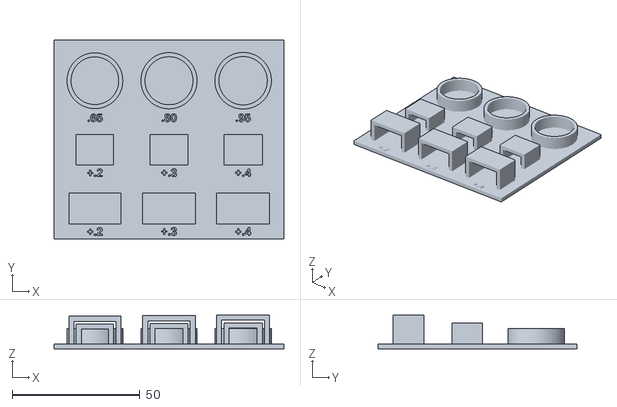
[picture p48: CAD file, 2026-10-26]
hardware/printed/stl/00_fit_coupon.stl
90.0 x 78.0 x 13.2
