joey12725/bubblelink/hardware/printed/stl/35_TPU_prime_plunger.stl

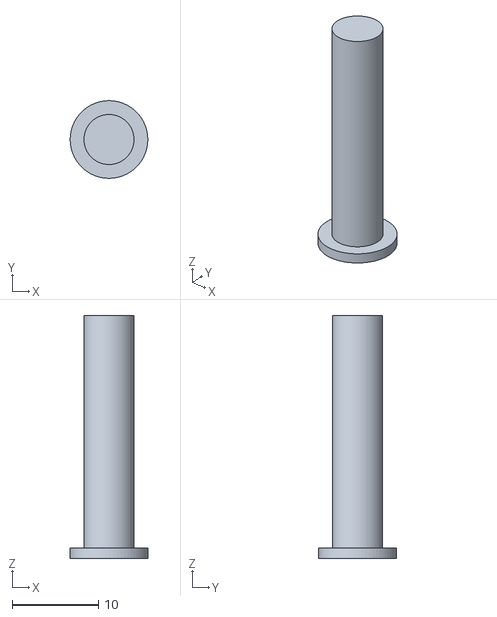
[picture p49: CAD file, 2026-10-26]
hardware/printed/stl/35_TPU_prime_plunger.stl
9.00 x 9.00 x 28.1
