joey12725/bubblelink/hardware/printed/stl/00_stick_coupon_skirt.stl

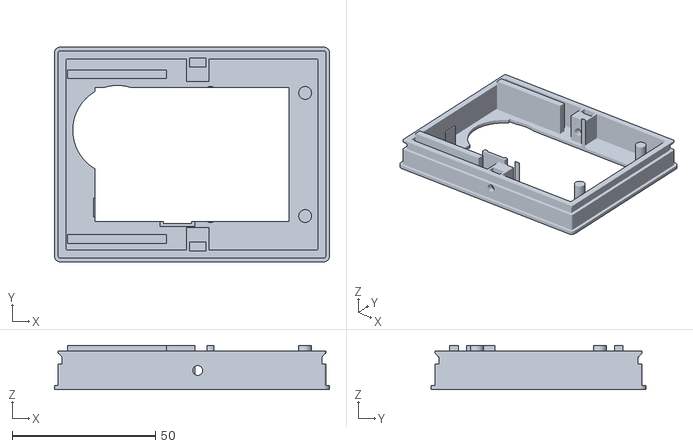
[picture p50: CAD file, 2026-10-26]
hardware/printed/stl/00_stick_coupon_skirt.stl
96.0 x 75.0 x 15.5
