joey12725/bubblelink/hardware/printed/stl/26_stick_power_key.stl

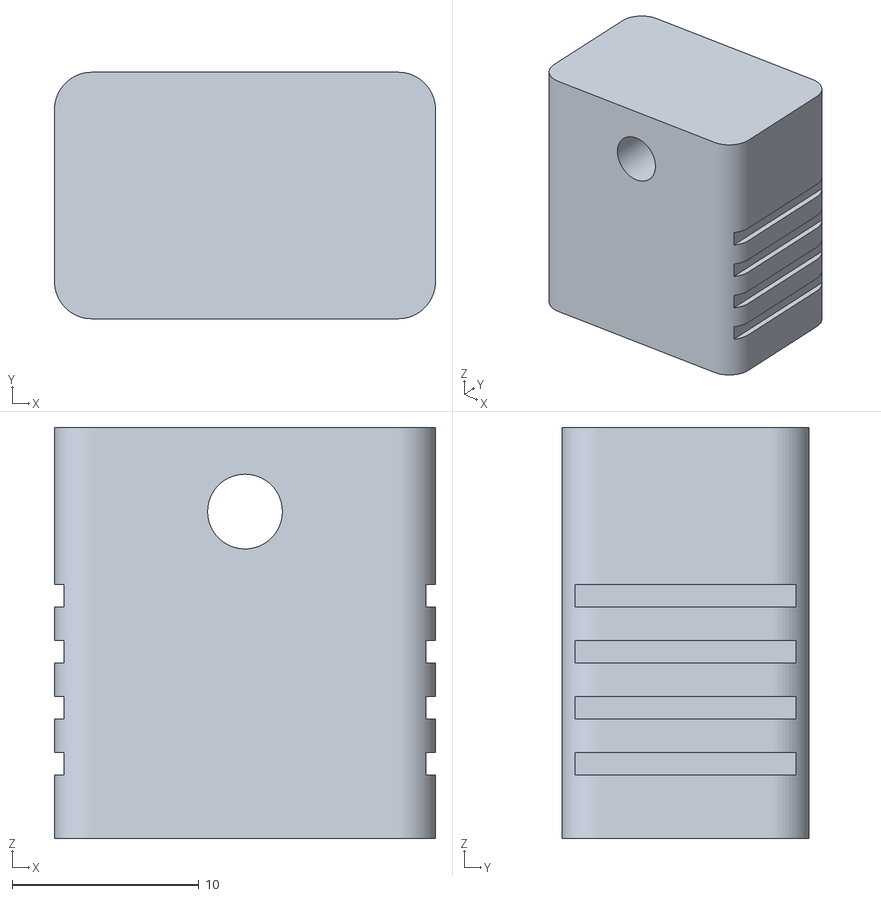
[picture p51: CAD file, 2026-10-26]
hardware/printed/stl/26_stick_power_key.stl
20.4 x 13.2 x 22.0
