joey12725/bubblelink/(list of files, cad)

Other CAD files:
hardware/printed/stl/72_duo_main_R.stl
hardware/printed/stl/71_duo_cover_L.stl
hardware/printed/stl/61_gun_dock_1head.stl
hardware/printed/stl/64_gun_dock_4head.stl
hardware/printed/stl/66_gun_dock_6head.stl
hardware/printed/stl/68_gun_dock_8head.stl
hardware/printed/stl/63_gun_dock_3head.stl
hardware/printed/stl/65_gun_dock_5head.stl
hardware/printed/stl/11_hose_adapter_8.5mm.3mf
hardware/printed/stl/02_cell_holder_TERM.stl
hardware/printed/stl/00_stick_coupon_nut.stl
hardware/printed/stl/11_hose_adapter_8.0mm.stl
hardware/printed/stl/11_hose_adapter_8.5mm.stl
hardware/printed/stl/11_hose_adapter_9.0mm.stl
hardware/printed/stl/34_TPU_screw_washer_x2.stl
