joey12725/bubblelink/hardware/printed/renders/battery_build.html

# Building the 2S5P battery block

10 Samsung 25R cells, two printed holders (MID and TERM, the 0.8 mm-lip version from 2026-10-16), nickel tabs on both faces. Step through it, or press Play. The geometry matches the holders: 19.9 mm between neighbouring cells, 26 mm tabs.

← Back ▶ Play Next →

pack − bus (row A, TERM face) pack + bus (row B, TERM face) midpoint mesh (MID face) fish paper

### Soldering, if you're not spot-welding

Scuff the tab and the cell end with fine sandpaper, then wipe with alcohol. Use flux paste: rosin-core solder alone won't wet nickel-plated steel. Tin the tabs off the battery first (they tin easily when no cell is soaking up the heat), then tin each cell end with a 1–2 s touch, and join by pressing the iron on the tab. Biggest chisel tip, 400–450 °C, a blob of solder on the tip as a heat bridge. Under 3 s per contact. Amber residue = burnt flux = not enough heat getting in. Never hot glue as the connection; it's fine over a good joint.

### The two meter checks

After the TERM face, the two chains read 3.6–4.2 V apart (0 V means a tab bridges them). After the MID face they read 7.2–8.4 V (about 4 V means a row is in backwards).

### Tabs

Every pair of neighbouring cells is 19.9 mm apart, in a row or across the rows, so each 26 mm tab bridges exactly one pair. TERM gets 8 tabs, MID gets 13: 21 of your 30.

← Back to the stick views and downloads
