joey12725/bubblelink/hardware/pcb/hand_solder_guide/1_values_and_wiring.png

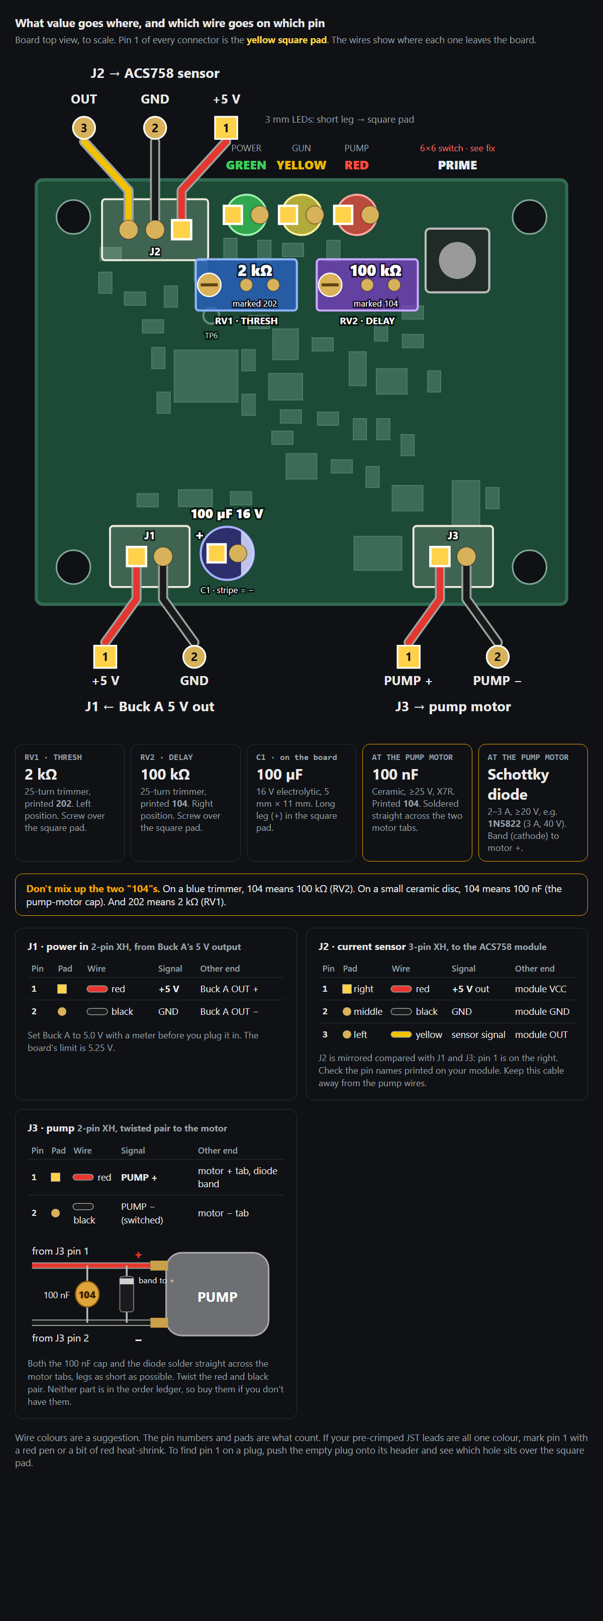
hardware/pcb/hand_solder_guide/1_values_and_wiring.png
