joey12725/bubblelink/hardware/pcb/hand_solder_guide/3_system_wiring.png

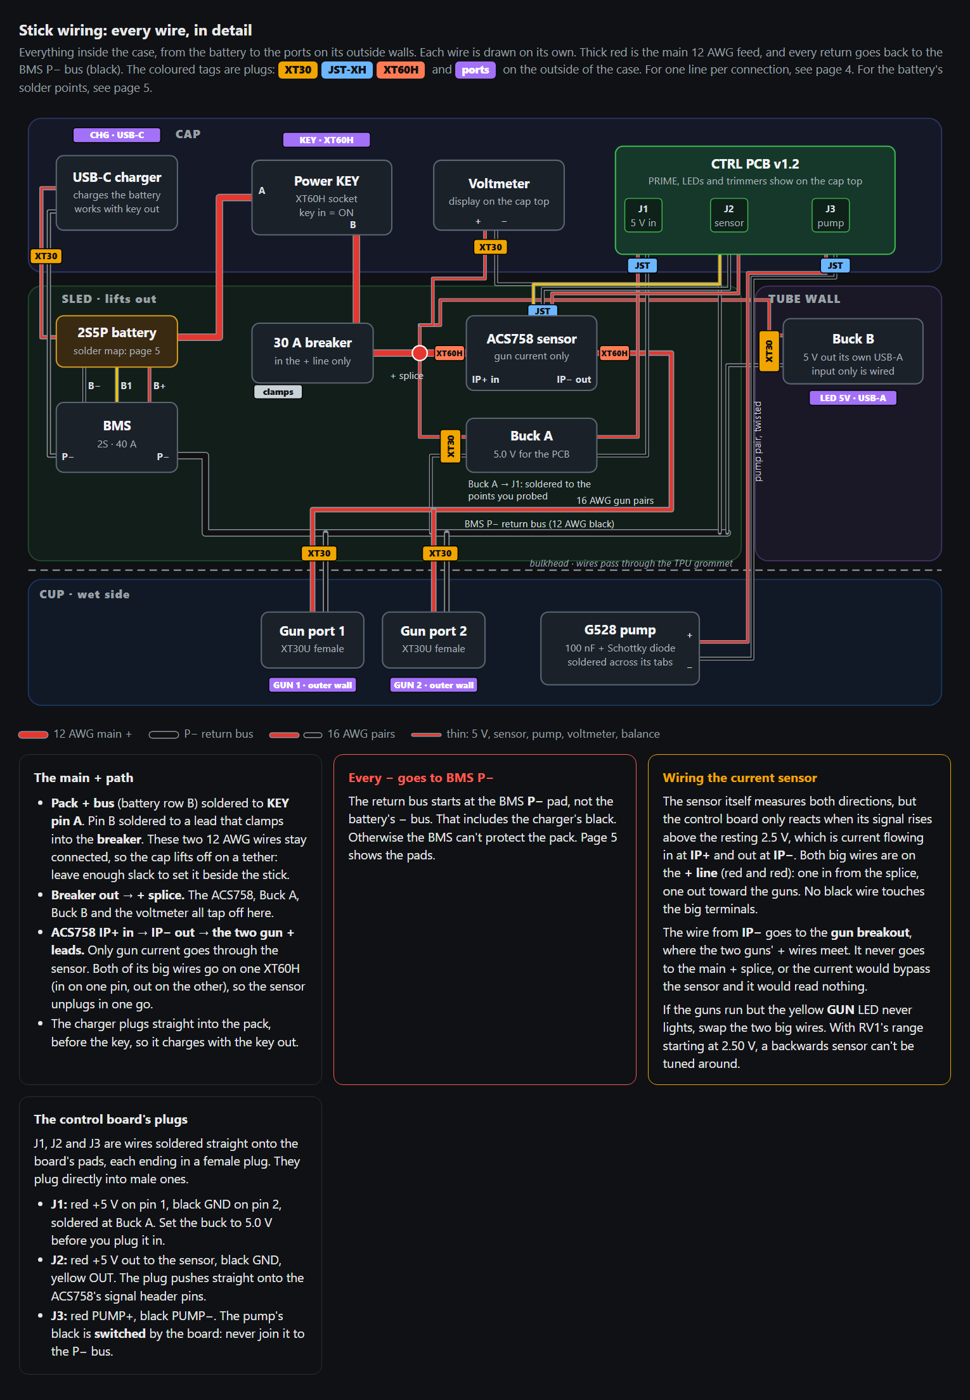
hardware/pcb/hand_solder_guide/3_system_wiring.png
