joey12725/bubblelink/hardware/pcb/hand_solder_guide/4_plug_map.png

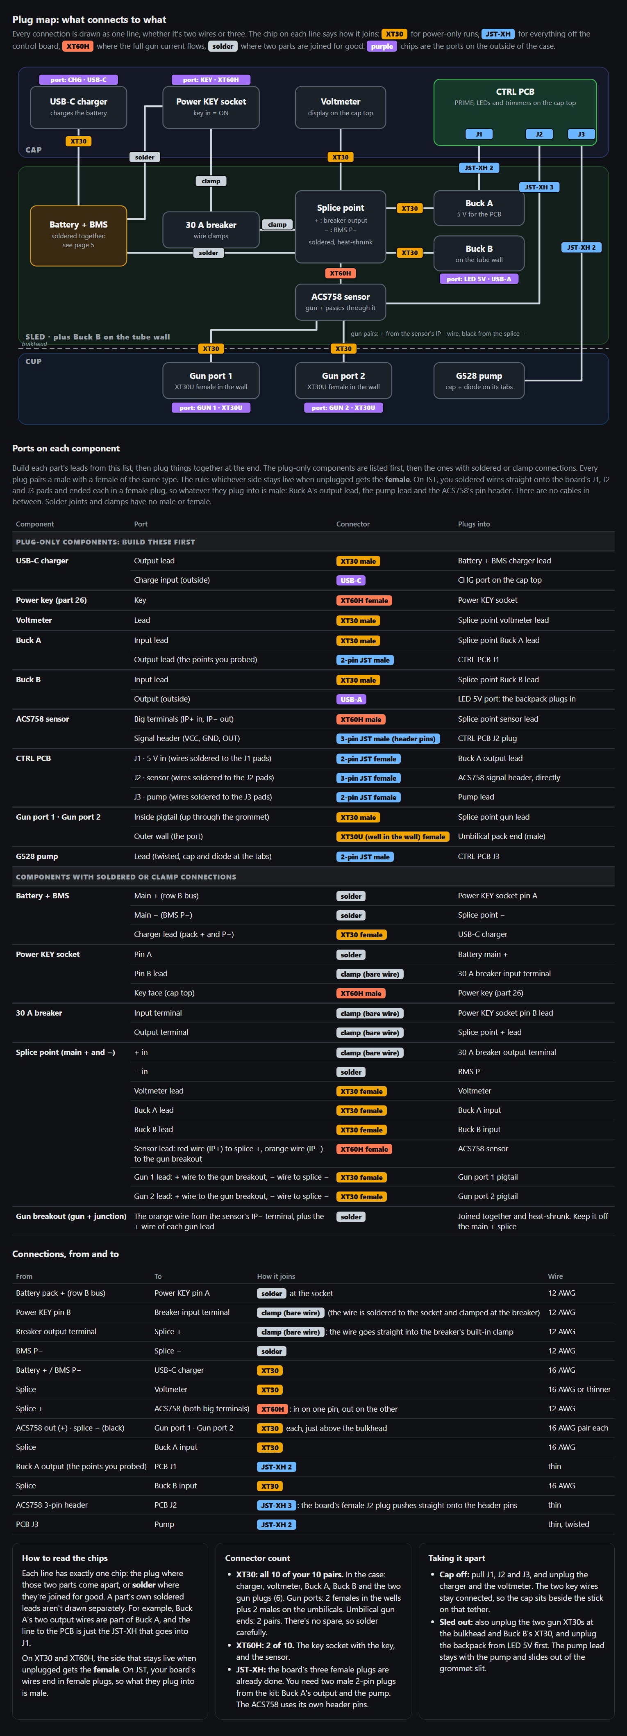
hardware/pcb/hand_solder_guide/4_plug_map.png
