joey12725/bubblelink/hardware/pcb/hand_solder_guide/5_battery_and_bms.png

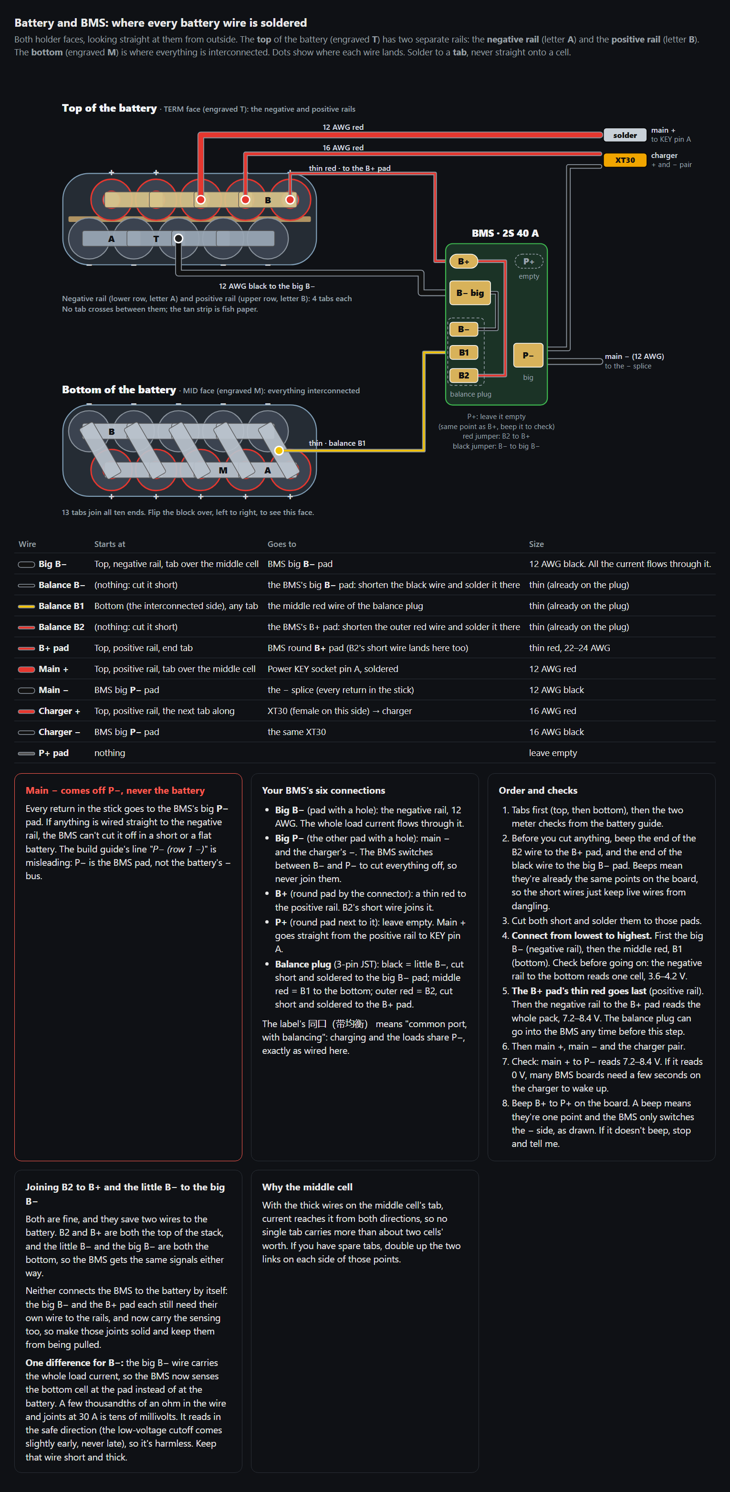
hardware/pcb/hand_solder_guide/5_battery_and_bms.png
