joey12725/bubblelink/hardware/pcb/hand_solder_guide/6_soldered_blob.png

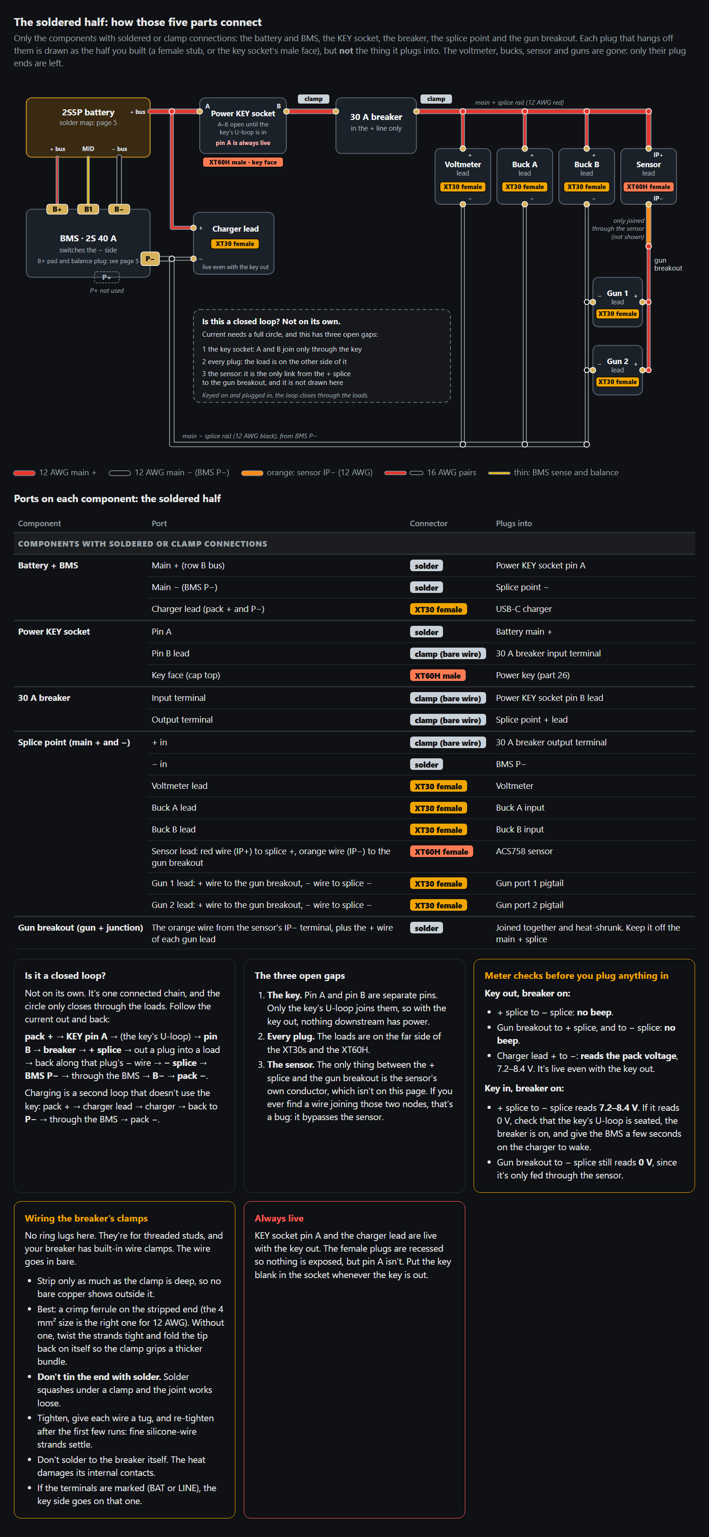
hardware/pcb/hand_solder_guide/6_soldered_blob.png
