joey12725/bubblelink/hardware/pcb/hand_solder_guide/7_how_the_bms_cuts_power.png

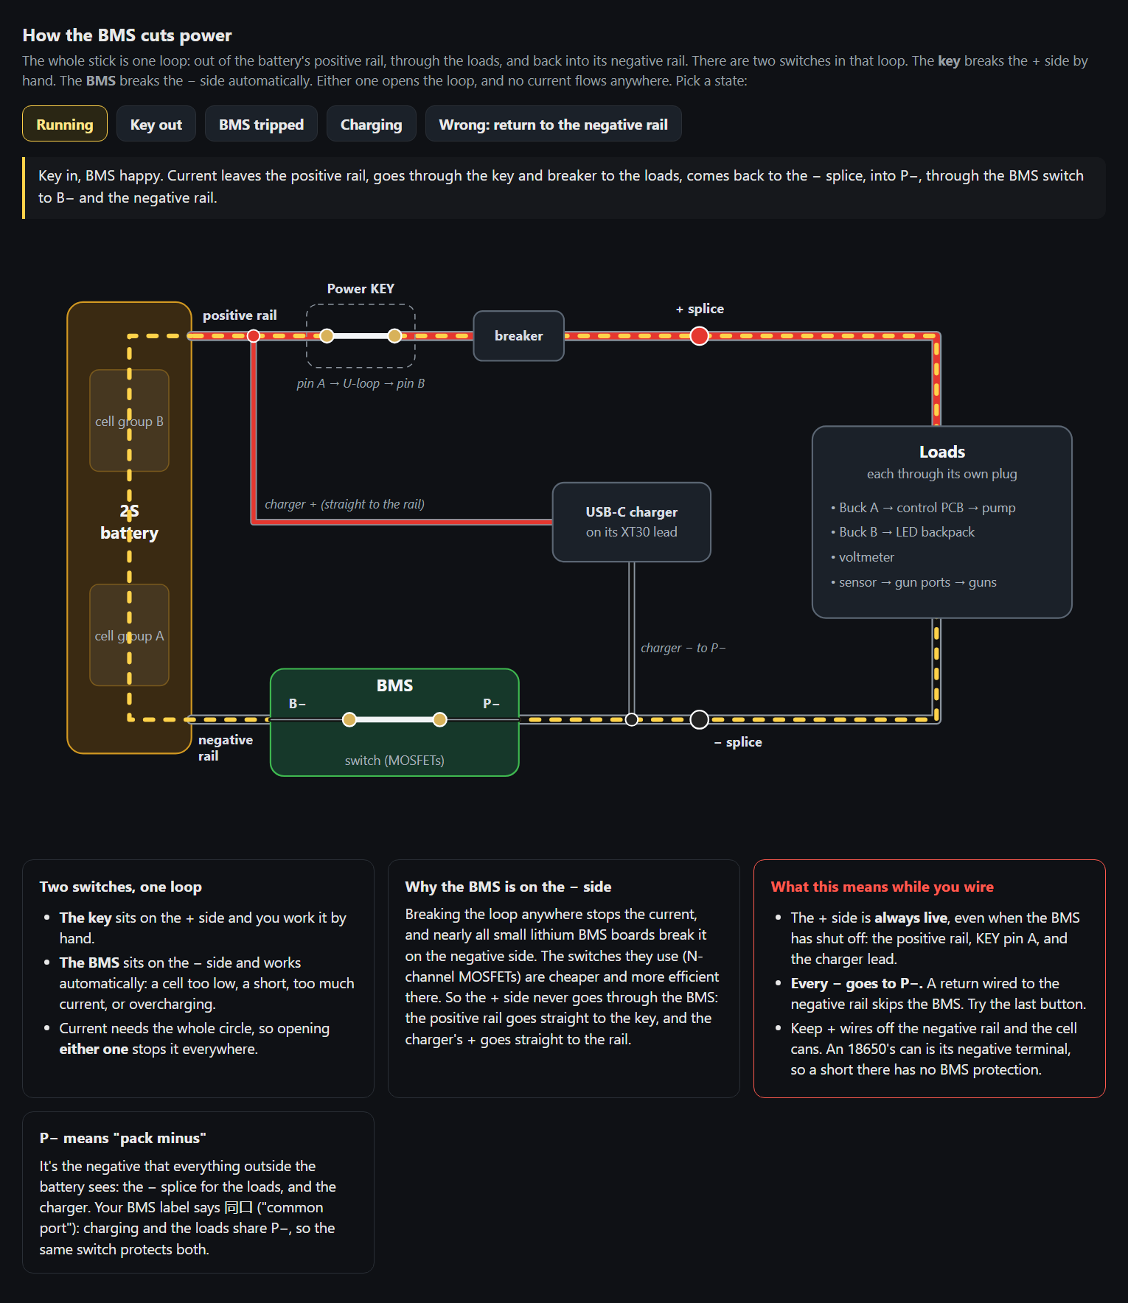
hardware/pcb/hand_solder_guide/7_how_the_bms_cuts_power.png
