joey12725/bubblelink/hardware/printed/renders/2_cap_top.png

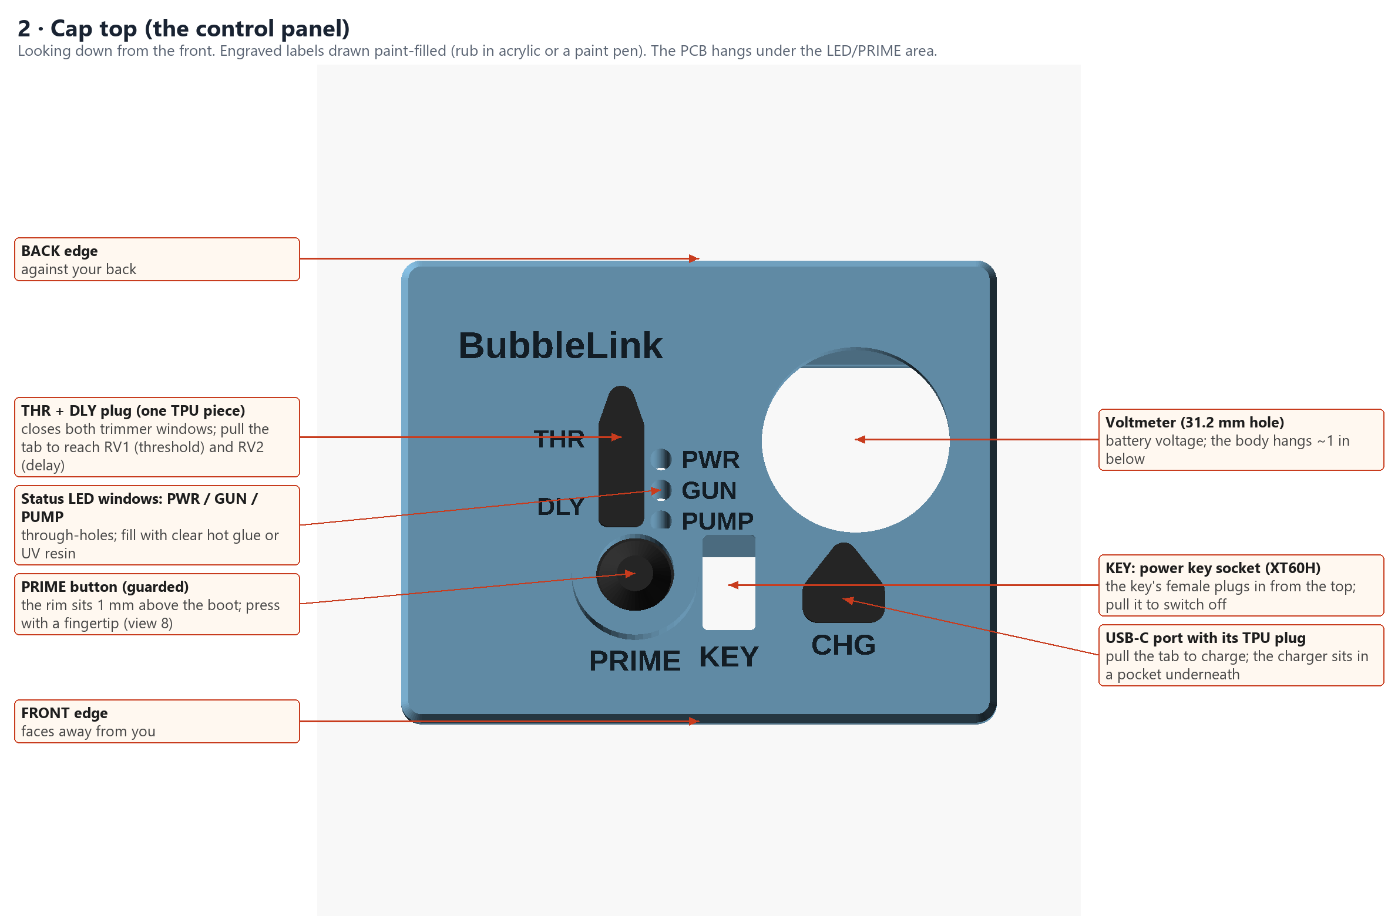
hardware/printed/renders/2_cap_top.png
