joey12725/bubblelink/hardware/printed/renders/4_cap_off_back_cutaway.png

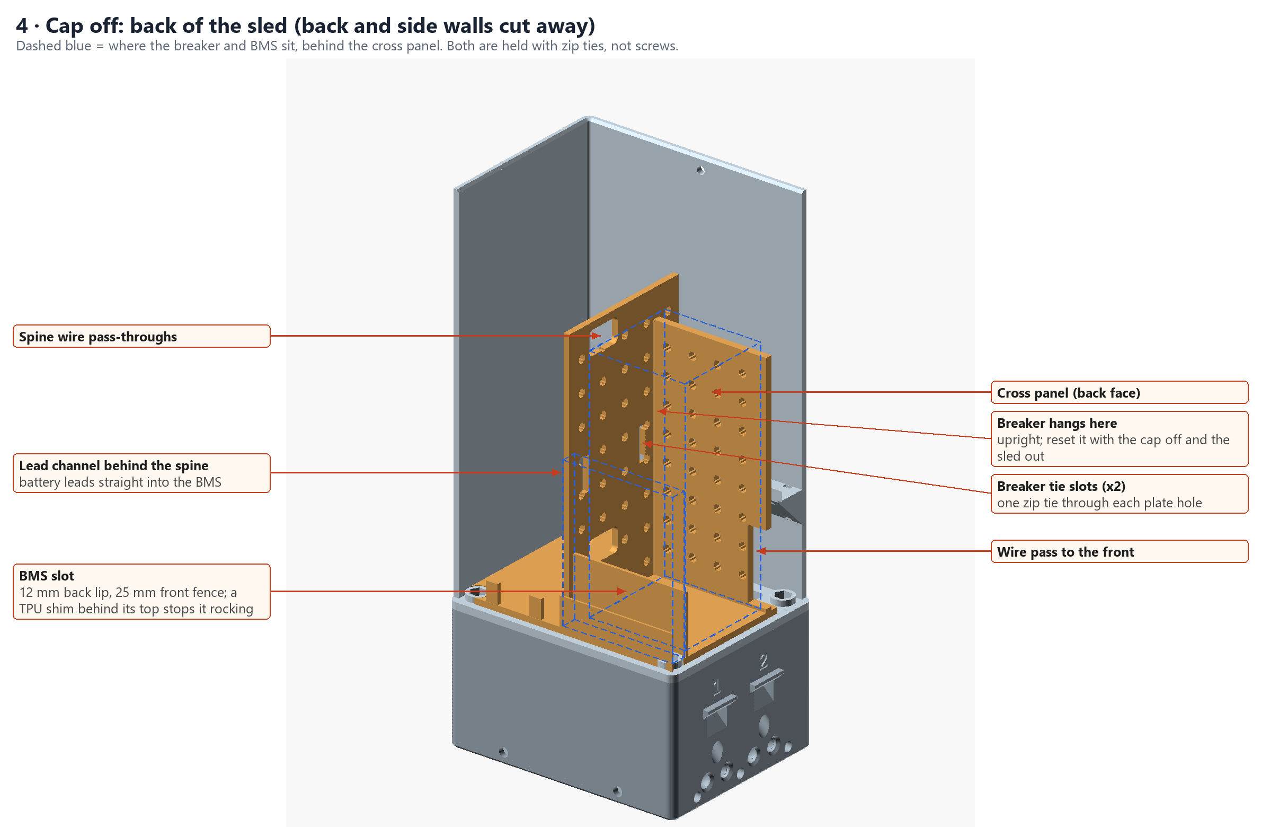
hardware/printed/renders/4_cap_off_back_cutaway.png
