joey12725/bubblelink/hardware/printed/renders/5_cap_underside.png

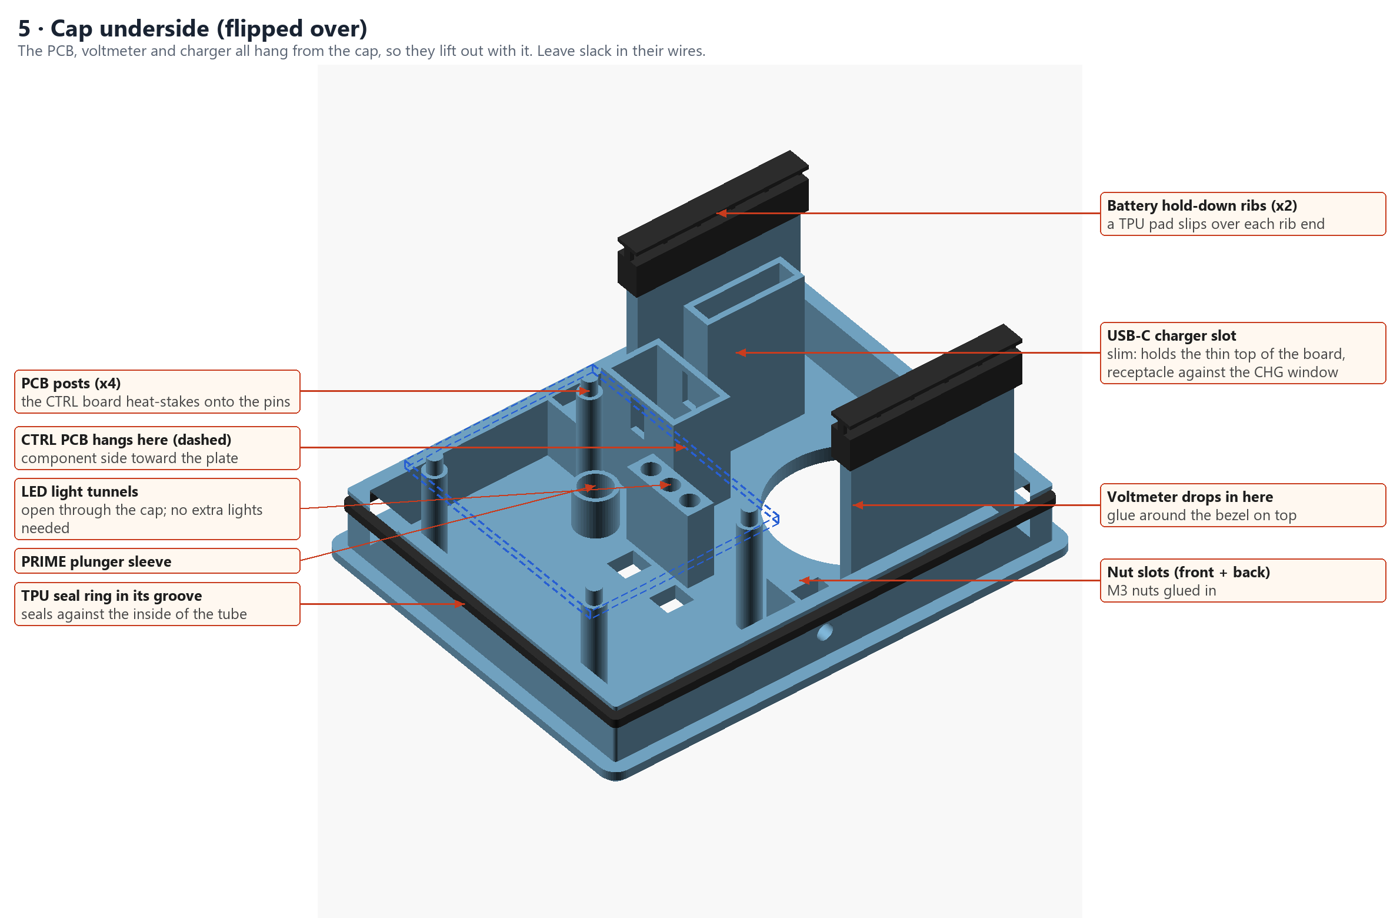
hardware/printed/renders/5_cap_underside.png
