joey12725/bubblelink/hardware/printed/renders/6_cup_interior.png

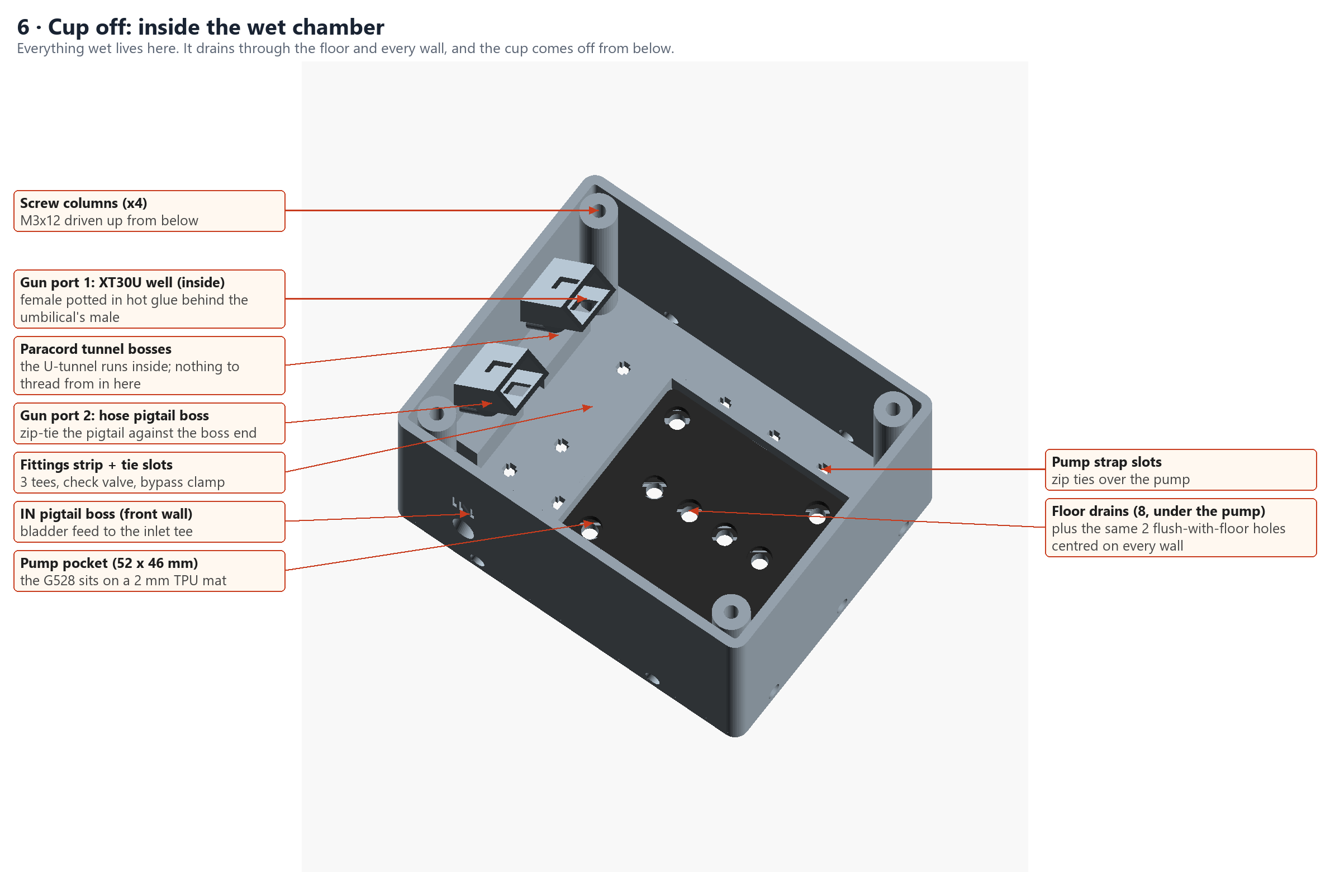
hardware/printed/renders/6_cup_interior.png
