joey12725/bubblelink/hardware/printed/renders/7_bulkhead_underside.png

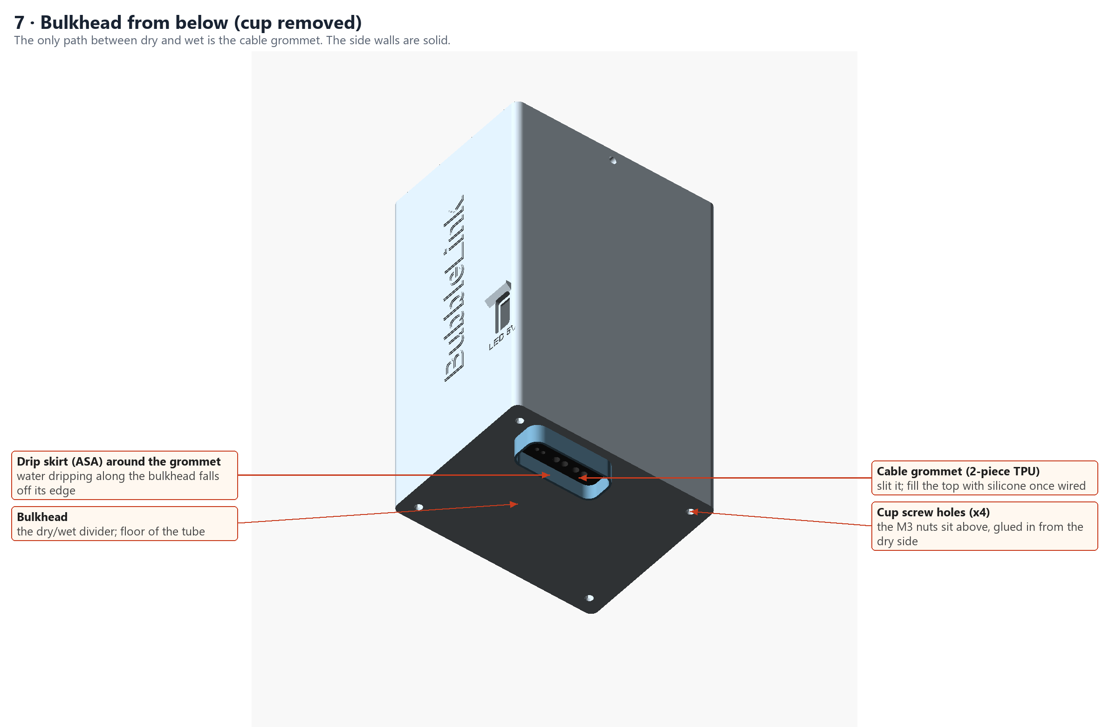
hardware/printed/renders/7_bulkhead_underside.png
