joey12725/bubblelink/hardware/printed/renders/8_prime_section.png

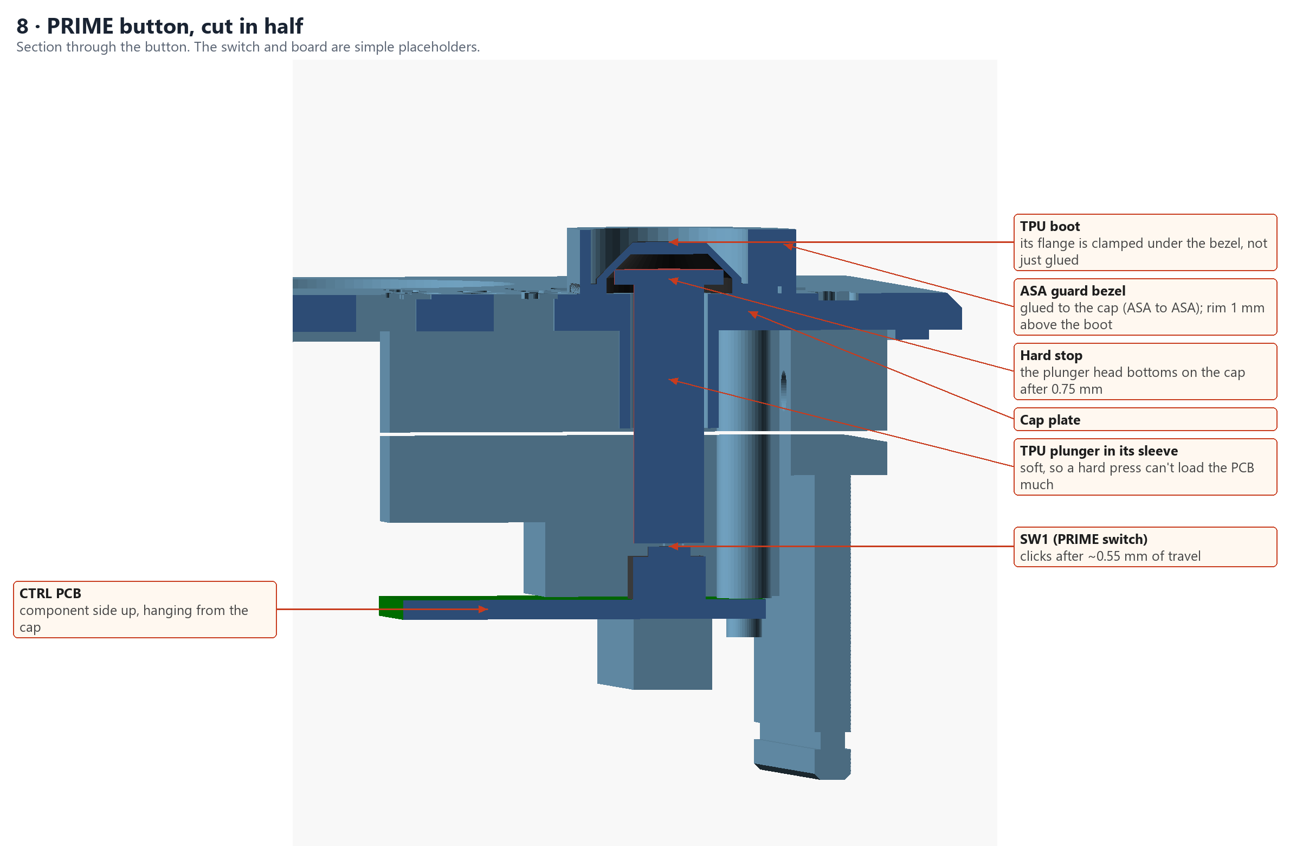
hardware/printed/renders/8_prime_section.png
