joey12725/bubblelink/hardware/printed/renders/9_gun_power_and_paracord.png

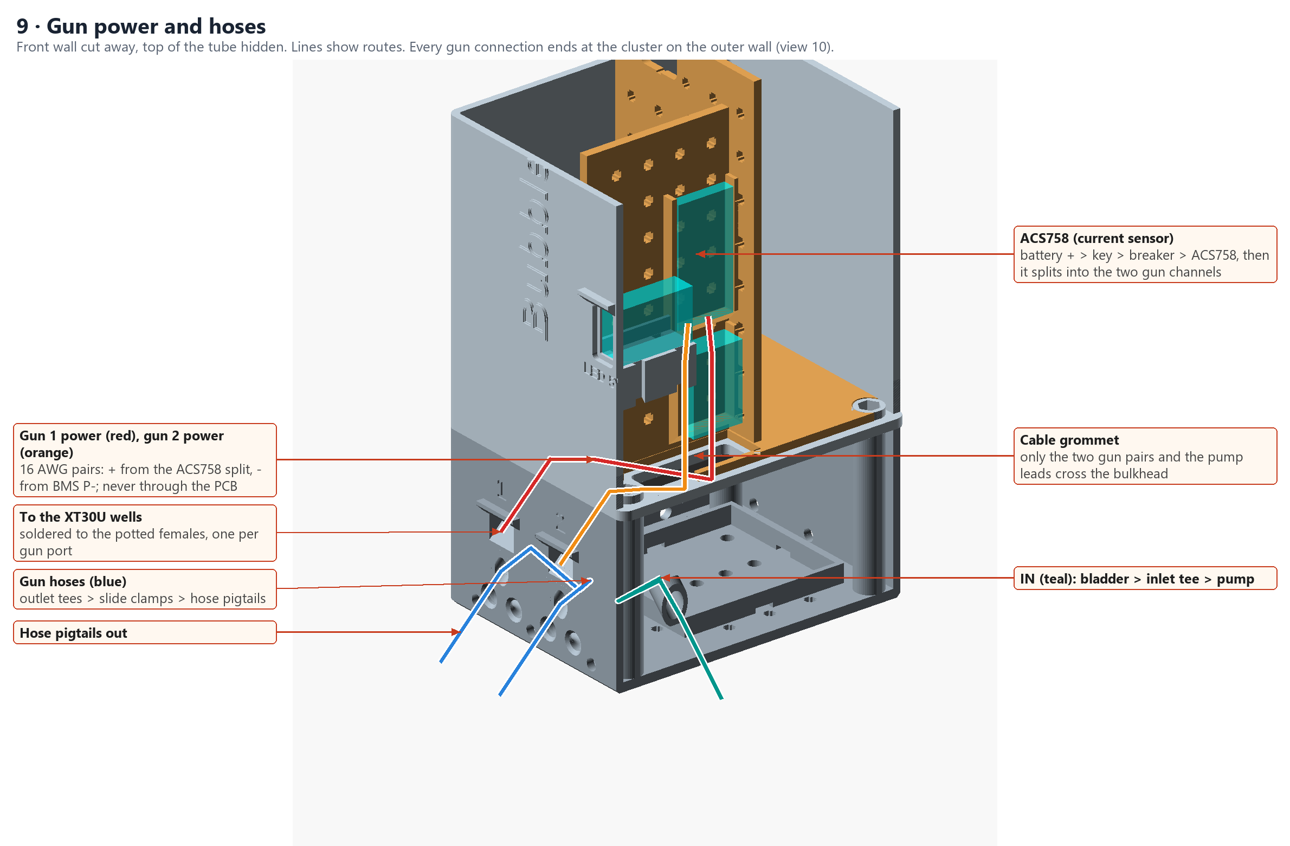
hardware/printed/renders/9_gun_power_and_paracord.png
