joey12725/bubblelink/hardware/printed/renders/10_gun_ports_closeup.png

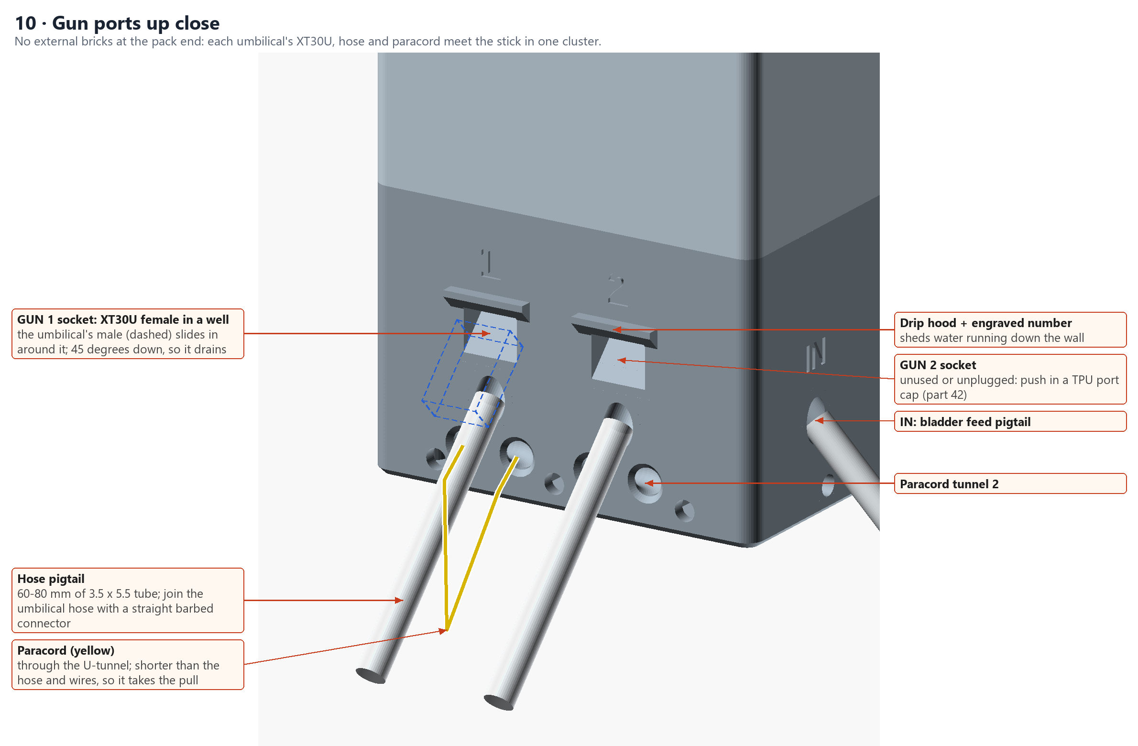
hardware/printed/renders/10_gun_ports_closeup.png
