joey12725/bubblelink/hardware/printed/renders/11_blower_head_assembly.png

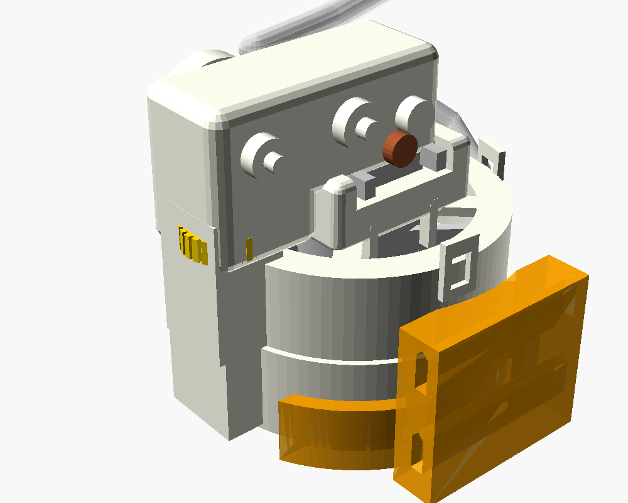
hardware/printed/renders/11_blower_head_assembly.png
