joey12725/bubblelink/hardware/printed/renders/12_blower_head_collar.png

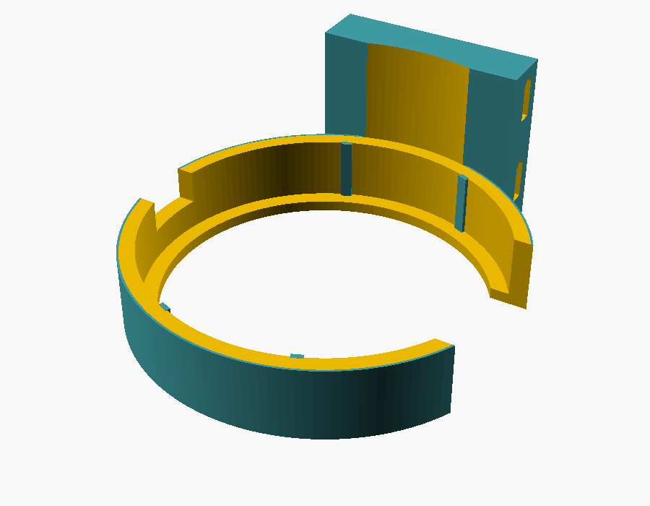
hardware/printed/renders/12_blower_head_collar.png
