joey12725/bubblelink/hardware/printed/renders/13_blower_head_photo_vs_model.png

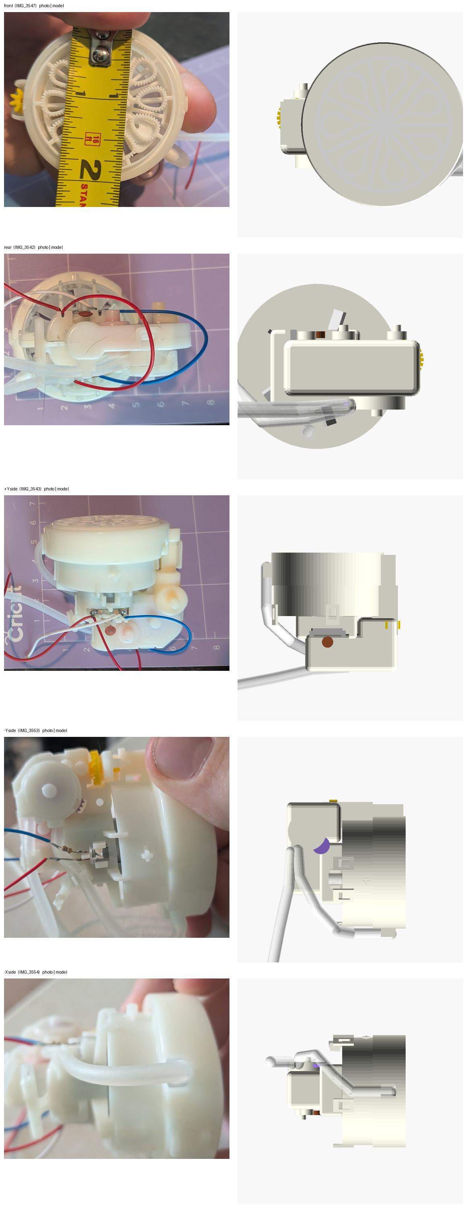
hardware/printed/renders/13_blower_head_photo_vs_model.png
