joey12725/bubblelink/hardware/printed/renders/15_duo_gun_front.png

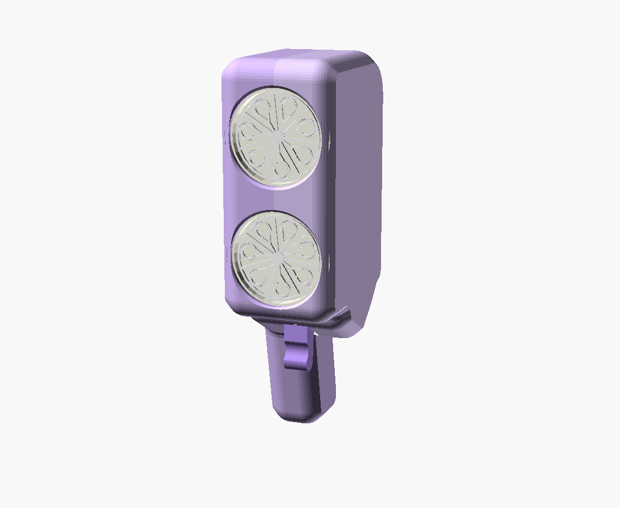
hardware/printed/renders/15_duo_gun_front.png
