joey12725/bubblelink/hardware/printed/renders/15_duo_gun_grip_side.png

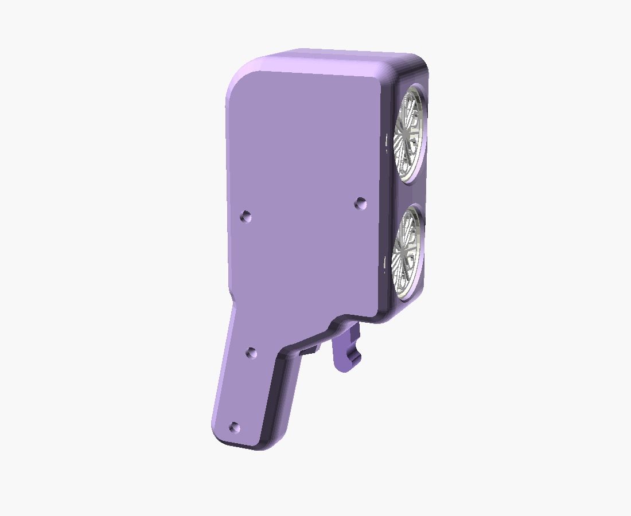
hardware/printed/renders/15_duo_gun_grip_side.png
