joey12725/bubblelink/hardware/printed/renders/15_duo_gun_pulled.png

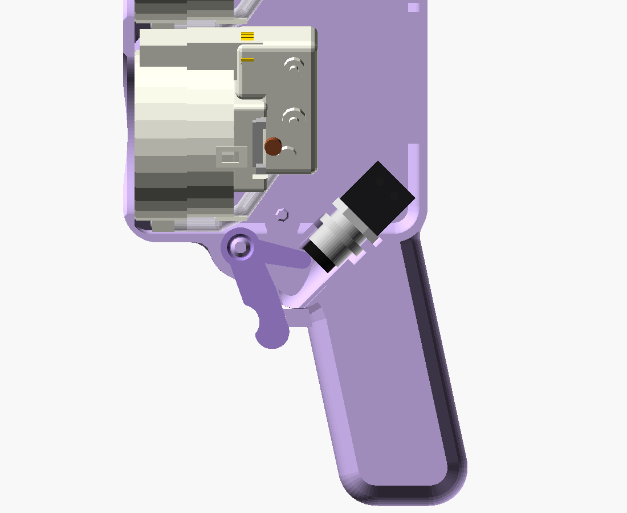
hardware/printed/renders/15_duo_gun_pulled.png
