joey12725/bubblelink/hardware/printed/renders/15_duo_gun_rear.png

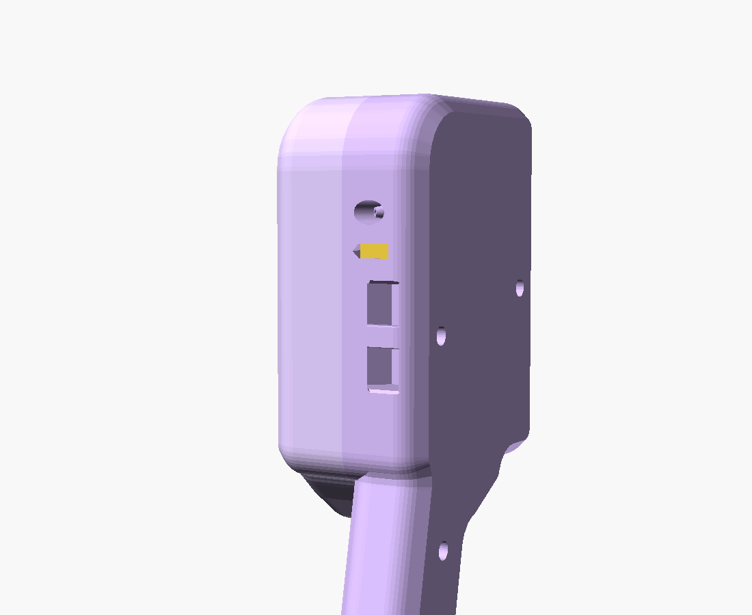
hardware/printed/renders/15_duo_gun_rear.png
