joey12725/bubblelink/hardware/pcb/BubbleLink_CTRL_v1_2_PCBWay/verification/analog_model/monte_carlo_results.csv

metric | unit | minimum | p01 | median | p99 | maximum
detector_hysteresis_mv | mV | 4.01040946554 | 4.08947572101 | 4.38737574678 | 4.68443078661 | 4.76411592259
timer_hysteresis_mv | mV | 7.49115241388 | 7.6518298498 | 8.20663660191 | 8.77605767073 | 8.92996456537
timer_minimum_delay_ms | ms | 23.0021437687 | 24.0975115359 | 34.0996486656 | 44.3990305978 | 45.9487826833
timer_maximum_delay_ms | ms | 378.364363745 | 392.749215205 | 555.233050411 | 718.591318628 | 736.645262495
target_350_position | fraction | 0.419654188602 | 0.431695412128 | 0.583782245392 | 0.873302968396 | 0.912554900682
q1_start_latency_ms | ms | 6.14622774384 | 6.40565091308 | 9.48800498621 | 13.345310593 | 14.6154591556
q1_required_current_ua | uA | 162.438568555 | 163.946405513 | 173.078800412 | 182.498216715 | 184.551893604
q1_vgs_overdrive_v | V | 0.830019312027 | 0.867174342554 | 1.05774750686 | 1.24718634635 | 1.29073168525
q2_fail_off_gate_v | V | 1.46537735934e-07 | 9.29848316611e-05 | 0.00503392982118 | 0.00989821436591 | 0.0100853425029
r21_fail_safe_delay_s | s | 3.35050924847 | 3.5786481531 | 5.3252069673 | 7.30557687297 | 7.83089255684
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
