joey12725/bubblelink/hardware/pcb/hand_solder_guide/8_plug_in_and_test.png

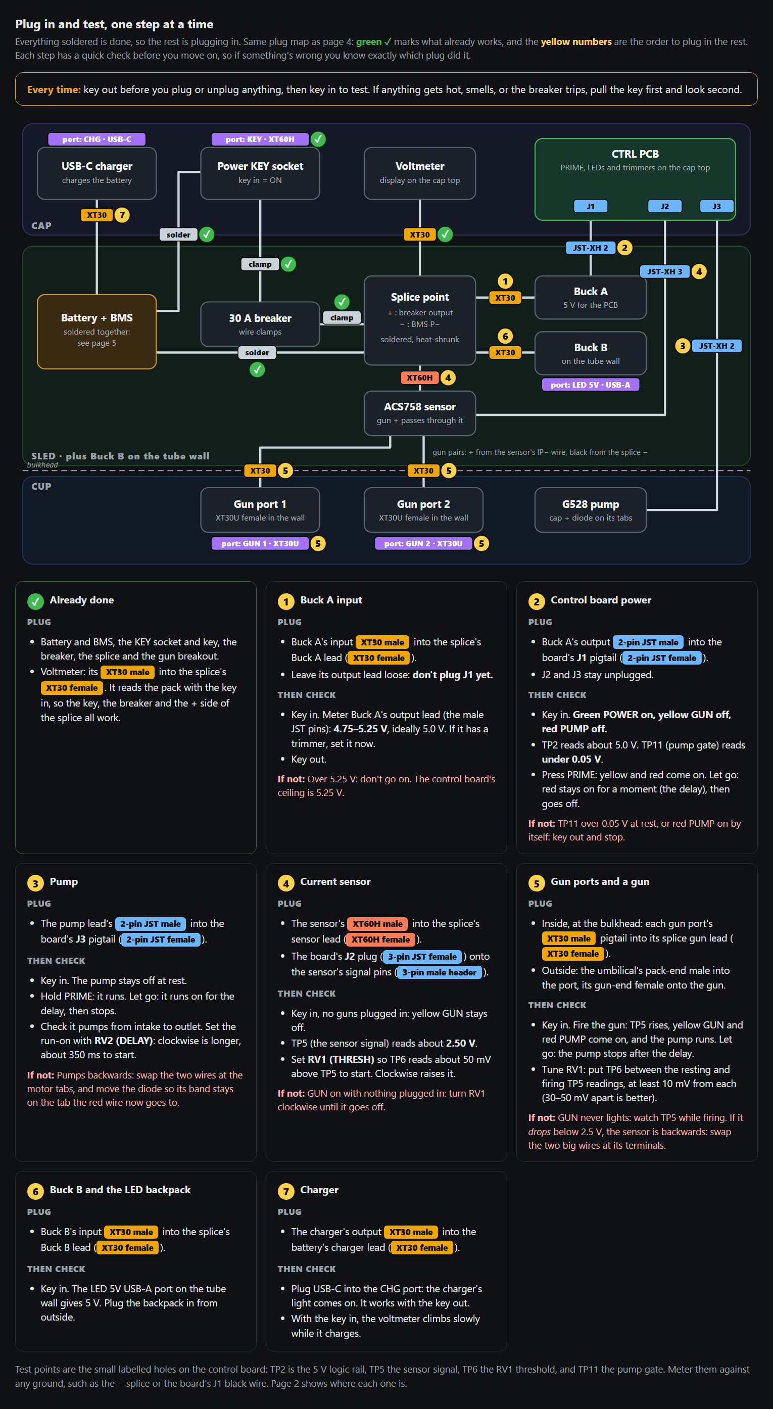
hardware/pcb/hand_solder_guide/8_plug_in_and_test.png
