joey12725/bubblelink/hardware/pcb/hand_solder_guide/2_placement_and_fixes.png

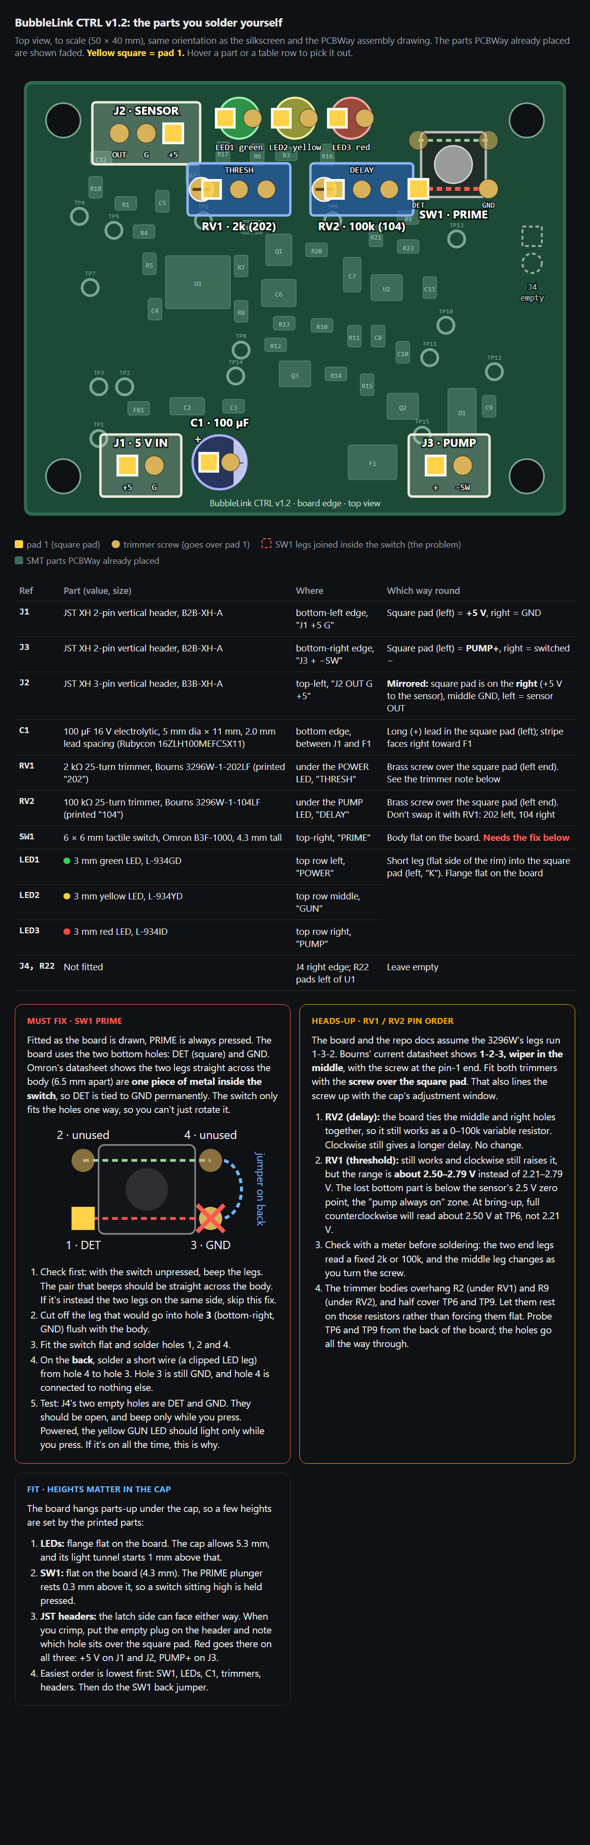
hardware/pcb/hand_solder_guide/2_placement_and_fixes.png
