joey12725/bubblelink/hardware/pcb/BubbleLink_CTRL_v1_2_PCBWay/source/BubbleLink_CTRL_v1_2.kicad_pcb

## KiCad design hardware/pcb/BubbleLink_CTRL_v1_2_PCBWay/source/BubbleLink_CTRL_v1_2.kicad_pcb (2026-10-14)

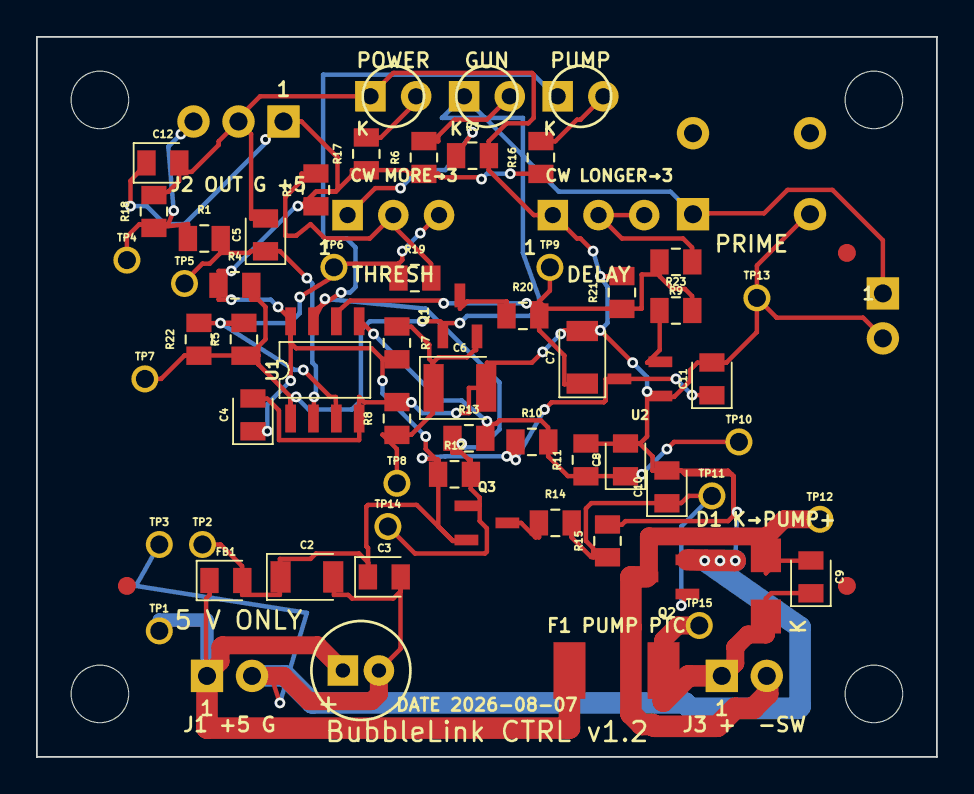
[picture p77: board BubbleLink_CTRL_v1_2.kicad_pcb from above]

Board: 2 copper layers, 50.0 x 40.0 mm, 68 parts (0 on the bottom side), 23 nets.

Parts:
C1: 16ZLH100MEFC5X11
C2: 10uF; GRM31CR71C106KA12L
C3, C4, C8, C9, C10, C11, C12: 100nF; GRM21BR71H104KA01L
C5: 1uF; GRM21BR71C105KA01L
C6: 22uF; C3225X7R1E226M250AB
C7: 6.8uF; CGA5L1X7R1E685K160AC
D1: B340A-E3/61T; B340A-E3_61T
F1: F1; 1812L150_16DR
FB1: BLM21PG221SN1D
J1, J3: B2B-XH-A(LF)(SN)
J2: B3B-XH-A(LF)(SN)
J4: chip
LED1: L-934GD
LED2: L-934YD
LED3: L-934ID
Q1, Q3: DMP2065UQ-7
Q2: AO3400A
R1, R4, R9, R11, R12, R15: 10kΩ; RC0805FR-0710KL
R2, R3: 7.5kΩ; RC0805FR-077K5L
R5, R13, R22: 4.7MΩ; RC0805FR-074M7L
R6, R16, R17, R20: 2.2kΩ; RC0805FR-072K2L
R7, R8: 4.7kΩ; RC0805FR-074K7L
R10: 39kΩ; RC0805FR-0739KL
R14: 100Ω; RC0805FR-07100RL
R18: 100kΩ; RC0805FR-07100KL
R19: 220kΩ; RC0805FR-07220KL
R21: 1MΩ; RC0805FR-071ML
R23: 560Ω; RC0805FR-07560RL
RV1: 3296W-1-202LF
RV2: 3296W-1-104LF
SW1: B3F-1000
TP1: TP1; test_point_platedhole_d1
TP2: TP2; test_point_platedhole_d1
TP3: TP3; test_point_platedhole_d1
TP4: TP4; test_point_platedhole_d1
TP5: TP5; test_point_platedhole_d1
TP6: TP6; test_point_platedhole_d1
TP7: TP7; test_point_platedhole_d1
TP8: TP8; test_point_platedhole_d1
TP9: TP9; test_point_platedhole_d1
TP10: TP10; test_point_platedhole_d1
TP11: TP11; test_point_platedhole_d1
TP12: TP12; test_point_platedhole_d1
TP13: TP13; test_point_platedhole_d1
TP14: TP14; test_point_platedhole_d1
TP15: TP15; test_point_platedhole_d1
U1: TLV1822QDRQ1
U2: TLV803EA43DBZR

Connections:
.F1 > .pin2 to .J3 > .pin1: C9.1, D1.1, F1.2, J3.1, TP15.1
.FB1 > .pin2 to .C2 > .pin1: C2.1, C3.1, C4.1, C11.1, C12.1, FB1.2, J2.1, Q3.2, R2.1, R4.1, R6.1, R7.1, R10.1, R12.1, R16.1, R17.1, TP2.1, U1.8, U2.3
.J1 > .pin1 to .F1 > .pin1: C1.1, F1.1, FB1.1, J1.1, TP1.1
.J1 > .pin2 to .Q2 > .pin2: C1.2, C2.2, C3.2, C4.2, C5.2, C6.2, C7.2, C8.2, C10.2, C11.2, C12.2, J1.2, J2.2, J4.2, LED1.1, Q2.2, R3.2, R8.2, R11.2, R15.2, R18.2, R21.2, RV2.1, SW1.3, TP3.1, TP13.1, U1.4, U2.1
.J2 > .pin3 to .R18 > .pin1: J2.3, R1.1, R18.1, TP4.1
.Q1 > .pin3 to .R20 > .pin1: Q1.3, R20.1
.Q2 > .pin3 to .J3 > .pin2: C9.2, D1.2, J3.2, Q2.3, TP12.1
.Q3 > .pin3 to .R14 > .pin1: Q3.3, R14.1
.R1 > .pin2 to .C5 > .pin1: C5.1, R1.2, TP5.1, U1.2
.R2 > .pin2 to .RV1 > .pin3: R2.2, R19.2, RV1.3
.R6 > .pin2 to .LED2 > .pin2: LED2.2, R6.2
.R7 > .pin2 to .C6 > .pin1: C6.1, Q1.2, R7.2, R8.1, TP8.1
.R9 > .pin2 to .RV2 > .pin3: R9.2, RV2.2, RV2.3
.R14 > .pin2 to .R15 > .pin1: C10.1, Q2.1, R14.2, R15.1, TP11.1
.R16 > .pin2 to .LED3 > .pin2: LED3.2, R16.2
.R17 > .pin2 to .LED1 > .pin2: LED1.2, R17.2
.RV1 > .pin1 to .R3 > .pin1: R3.1, RV1.1
.RV1 > .pin2 to .R19 > .pin1: R5.2, R19.1, R22.2, RV1.2, TP6.1, U1.3
.U1 > .pin1 to .R5 > .pin1: J4.1, LED2.1, Q1.1, R4.2, R5.1, R22.1, SW1.1, TP7.1, U1.1
.U1 > .pin5 to .R13 > .pin2: C8.1, R10.2, R11.1, R13.2, TP10.1, U1.5
.U1 > .pin6 to .R20 > .pin2: C7.1, R9.1, R20.2, R21.1, R23.2, TP9.1, U1.6
.U1 > .pin7 to .R13 > .pin1: LED3.1, Q3.1, R12.2, R13.1, TP14.1, U1.7
.U2 > .pin2 to .R23 > .pin1: R23.1, U2.2
