joey12725/bubblelink/(commit log)

2026-10-14 BubbleLink project repository: final design docs and PCB v1.2 release
    Compiled from the design notes and the v1.2 PCB release package.
    [BubbleLink_CTRL_v1_2.kicad_pcb, BubbleLink_CTRL_v1_2.kicad_sch, CRITICAL_PAD1_COORDINATES.csv, DNP_AND_NO_PLACE.csv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]
2026-10-14 Add printed-parts CAD (upright "stick" pack) and update docs
    Parametric OpenSCAD sources and STLs in hardware/printed/ for the whole
    pack except the bladder: an upright stick (~99 x 78 x 207 mm) with a
    control-head cap (hung CTRL PCB, LED skin windows, PRIME plunger,
    voltmeter, USB-C), a dry tube with a slide-out sled (2S5P, breaker
    behind a TPU membrane window, BMS, bucks, ACS758 in compartments), a
    TPU-grommeted bulkhead, and a draining wet cup for the pump and
    fittings. Also the fit coupon, MID/TERM cell holders, slide clamps and
    umbilical bricks. Sized from Joey's 2026-10-14 part measurements and
    checked for watertight meshes and assembly interference; reviewed
    independently and the find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
    [00_fit_coupon.stl, 01_cell_holder_MID.stl, 02_cell_holder_TERM.stl, 09_slide_clamp_x3.stl, 10_umbilical_brick_x4.stl, 20_stick_tube.stl, 21_stick_cap.stl, 22_stick_sled.stl]
2026-10-15 Stick: TPU cushions replace foam, raised BubbleLink emboss, ASA print plan, fit coupons
    - TPU battery pads (compliant fins, snap beads), pump mat, shim set replace EVA foam
    - Cell holders get flat end faces so the pads load evenly
    - Raised BubbleLink lettering on the tube's outer wall
    - Charger pocket crush ribs (USB-C receptacle centred on short side confirmed)
    - Pump pocket corner drains and fence notches, sled battery stops
    - Three stick fit coupons (rim, skirt, nut); 23 STLs, all watertight
    - Docs: ASA printing guide, M3 thread/nut stack-up audit, foam removed, envelope ~100x80x220
    - Renders regenerated; design reviewed by GPT-6 Astra and Claude Fable (2 rounds)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
    [00_fit_coupon.stl, 00_stick_coupon_nut.stl, 00_stick_coupon_rim.stl, 00_stick_coupon_skirt.stl, 01_cell_holder_MID.stl, 02_cell_holder_TERM.stl, 09_slide_clamp_x3.stl, 10_umbilical_brick_x4.stl]
2026-10-15 Stick: TPU plugs for trimmer windows and USB-C, symmetric cup drains, numbered tie-offs, sled locating, hardware kit
    - 39 TPU trimmer plug (one piece closes RV1/THR and RV2/DLY), 40 TPU USB-C plug
    - Cup: the same pair of floor-flush drains centred on every wall; paracord tie-offs
    raised to 17 mm and numbered 1/2 to match engraved exit numbers
    - Sled base hugs the four bulkhead bosses (0.3 mm) so it can't slide or twist
    - Cup counterbore 0.8 mm deeper for M3 split lock washers; hardware list matched to
    the HVAKHVA M3 kit (flat washer over the TPU washer on the cap screws)
    - New render view 9: gun power wiring and paracord routing; docs updated (gun pairs
    come from the ACS758 split, not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
    [21_stick_cap.stl, 22_stick_sled.stl, 23_stick_cup.stl, 39_TPU_trimmer_plug.stl, 40_TPU_usbc_plug.stl, stick.scad]
2026-10-15 Stick: every input and output as a labelled port; integrated gun port clusters
    - Gun ports on the cup's outer wall: XT30U female potted in a 45-degree draining well
    (zip-tie rear keeper), hose pigtail, paracord U-tunnel, drip hood, number; TPU caps.
    Pack-end umbilical bricks dropped (10_umbilical_brick_x2, gun end only)
    - Power KEY on the cap (XT60H male socket + female key with 12 AWG loop, ASA grip,
    TPU blank and gasket) replaces the XT60H loop below the stick
    - Buck B moves onto a sled ledge with its own USB-A behind a window in the tube's outer
    wall (LED 5V): no extension cable or internal USB plug; TPU plug
    - Bladder IN pigtail on the front wall; floor exits and service hole rem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
    [00_stick_coupon_nut.stl, 00_stick_coupon_ports.stl, 00_stick_coupon_rim.stl, 00_stick_coupon_skirt.stl, 10_umbilical_brick_x2.stl, 20_stick_tube.stl, 21_stick_cap.stl, 22_stick_sled.stl]
2026-10-15 Print guide: cap-to-sled harness table (six runs, a disconnect in each)
2026-10-15 Battery tab layout in the build guide (MID mesh, two separate TERM buses); zip links
2026-10-16 Coupon results: cell bore 18.65, hose hole 6.0, USB-A window takes Buck B's socket
    - Buck B moves off the sled onto a shelf on the tube's front wall; its USB-A socket sits
    in a 14.0 x 6.6 window in the outer wall, so the sled lifts out past it
    - Hose pigtail holes 6.0 mm (5.4 was too tight); TPU USB-A plug fills the counterbore only
    - Nut pockets, XT30U well and XT60H key socket verified on the coupons
    - Fit coupon rows explained; renders, docs and zips updated
    [00_stick_coupon_ports.stl, 00_stick_coupon_rim.stl, 00_stick_coupon_skirt.stl, 01_cell_holder_MID.stl, 02_cell_holder_TERM.stl, 20_stick_tube.stl, 21_stick_cap.stl, 22_stick_sled.stl]
2026-10-16 fit_clear 0.20 from the coupon (XT30U snug at +0.2); brick rebuilt; zips trimmed to what's left to print
    [10_umbilical_brick_x2.stl, params.scad]
2026-10-16 Print guide: fit_clear result in the coupon notes
2026-10-16 Animated battery build guide (hardware/printed/renders/battery_build.html)
2026-10-16 Lid and sled fixes from the first prints
    - Voltmeter hole 31.2 mm (29.2 printed 1-2 mm small in ASA)
    - USB-C charger: slim slot 1.25x the receptacle thickness (~4.1 mm) instead of the
    9.5 mm pocket with crush ribs; the board's thick part hangs below
    - Sled base notched at the front-right corner so it slides down past the Buck B shelf
    - Optional cap coupon (voltmeter hole + charger slot); 32 STLs, all watertight
    - Renders, docs and the 'what's left to print' zip updated
    [00_stick_coupon_cap.stl, 00_stick_coupon_skirt.stl, 21_stick_cap.stl, 22_stick_sled.stl, stick.scad]
2026-10-16 Cell holders: 0.8 mm lip so tabs lie flat and the block fits; battery repositioned
    - holder_lip 2.0 -> 0.8: block 67.45 mm along the cells (was 69.85); reprint 01/02
    - Block sits 2.0 mm off the front wall and 3.55 mm off the back (tabs, solder, leads);
    cap pads follow; sled battery posts cut to 2 mm
    - Soldering guidance: scuff, flux paste, pre-tin tabs off the cell, no hot glue as a joint
    - Renders, docs, battery page and zips updated
    [00_stick_coupon_cap.stl, 00_stick_coupon_skirt.stl, 01_cell_holder_MID.stl, 02_cell_holder_TERM.stl, 21_stick_cap.stl, 22_stick_sled.stl, params.scad, stick.scad]
2026-10-26 Add PCB spacers, updated PRIME plunger, and hand-solder guides
    [27_stick_pcb_spacer_x6.stl, 35_TPU_prime_plunger.stl, stick.scad]
2026-10-28 Update power measurements, battery assembly guides, and hose adapters
    [11_hose_adapter_8.0mm.3mf, 11_hose_adapter_8.0mm.stl, 11_hose_adapter_8.5mm.3mf, 11_hose_adapter_8.5mm.stl, 11_hose_adapter_9.0mm.3mf, 11_hose_adapter_9.0mm.stl, hose_adapter.scad]
2026-10-28 Add donor blower-head model + test mount and the standard gun dock
    Blower head (parts 50-51): blower_head.scad holds a reference model of the
    7-wand donor head, measured from 16 photos (each dimension cites its photo),
    plus a gauge-ring set and a test C-collar. REF_blower_head.stl is for
    designing guns around; renders/13 compares the model with the photos.
    Gun dock (parts 60-69): gun_dock.scad is the standard umbilical panel for
    every gun shell (XT30U window, recessed inlet barb, carabiner bar, 1-8
    outlet barbs), with a barb-size coupon and a mount plate.
    [50_head_gauge_x5.stl, 51_head_collar_test.stl, 60_dock_barb_coupon.stl, 61_gun_dock_1head.stl, 62_gun_dock_2head.stl, 63_gun_dock_3head.stl, 64_gun_dock_4head.stl, 65_gun_dock_5head.stl]
2026-10-28 Make the gun docks and head collar print with no supports or bridges
    Every face of parts 50, 51 and 60-69 that isn't on the bed is now 45 degrees
    or shallower:
    - Docks: the hose socket (mouth chamfer, bore and 45-degree ceiling) is one
    profile, and the inlet barb root runs up into it, so there's no flat ledge
    at the ceiling. The 1-head dock's inlet bore ends in a 45-degree point.
    - Head collar (51): both zip-tie tunnels have 45-degree peaked roofs.
    check_stl.py checks the exported STLs: watertight, body count, and any
    overhang steeper than 45 degrees that isn't on the bed.
    [51_head_collar_test.stl, 61_gun_dock_1head.stl, 62_gun_dock_2head.stl, 63_gun_dock_3head.stl, 64_gun_dock_4head.stl, 65_gun_dock_5head.stl, 66_gun_dock_6head.stl, 67_gun_dock_7head.stl]
2026-10-28 Head collar: widen the gear-housing gap to 24 mm
    The first print of part 51 only fitted upside down: its 15 mm gap was too
    narrow on both sides of the yellow-gear housing. The gap is now 24 mm and
    centred, and the reference model's gear tab is 14 mm wide and centred too.
    The gauge rings use the same gap. Also adds head_rings() so gun shells can
    `use <blower_head.scad>`.
    [50_head_gauge_x5.stl, 51_head_collar_test.stl, REF_blower_head.stl, blower_head.scad]
2026-10-29 Add the Duo gun: a stacked left/right pair, three printed pieces per gun
    Compact two-head BubbleLink gun (hardware/printed/src/duo_gun.scad), made as a
    left/right pair that holds grip to grip in one hand. Per gun: a main half with
    the grip and the umbilical dock built in (XT30U window, hose inlet, carabiner
    bar, outlets), a cover half, and a trigger. All purple, glued shut, no
    supports.
    - GSW-21 push-on/push-off switch on a full-width bulkhead, pressed by a
    pegged trigger: 7.0 mm of button push at full pull (latches at 5, measured),
    with a stop boss at finger height so pull load bypasses the pivot pegs.
    - Crush ribs on the main half only; the cover half's sleeves are ~0.8 mm
    clear so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
    [00_duo_test_cover.stl, 00_duo_test_main.stl, 70_duo_main_L.stl, 71_duo_cover_L.stl, 72_duo_main_R.stl, 73_duo_cover_R.stl, 74_duo_trigger.stl, REF_blower_head.stl]
2026-11-13 Prepare BubbleLink for open-hardware release
    - New README: what it is, renders, how the controller works, build steps,
    verification commands, licensing.
    - docs/bom.md: full system BOM with part numbers and generic supplier links.
    - Licensing: CERN-OHL-P-2.0 (hardware), MIT (software), CC-BY-4.0 (docs and
    images); texts in LICENSES/.
    - PCB release: replace the fab handoff note with a README, drop order numbers
    from the release notes and drawing script, regenerate SHA256SUMS.txt.
    - Docs: remove purchase records, order and tracking numbers, prices, event
    schedules and stale status notes; point part references at the BOM;
    canonical facts rewritten as a design summary.
    - Remove the supe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
    [dry_core.scad, port_insert.scad, pump_module.scad, stick.scad]
2026-11-13 README: describe the STL set accurately
